parkourlrc/pcb-WantClueTechnologies--BitForge-Nano-ec7b885981/KiCad/BitForgeNano/3d/CUI_DEVICES_PJ-002AH.step

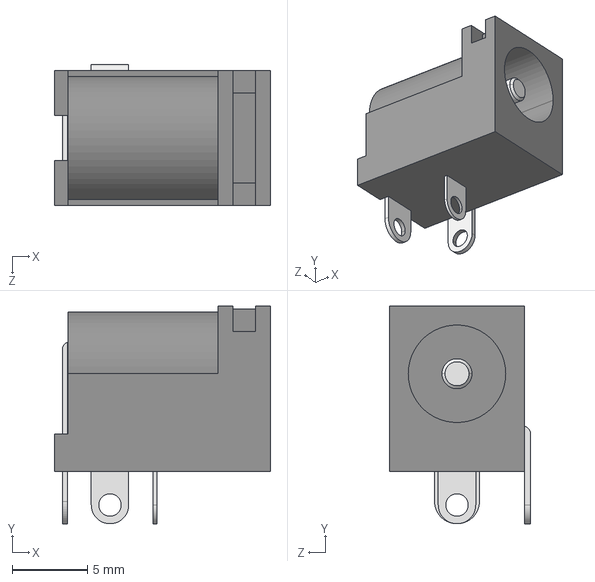
[picture p2: CAD file, 2025-12-21]
KiCad/BitForgeNano/3d/CUI_DEVICES_PJ-002AH.step
14.4 x 14.5 x 9.40 mm
