parkourlrc/pcb-WantClueTechnologies--BitForge-Nano-ec7b885981/KiCad/BitForgeNano/3d/TXB0104RGYR.STEP

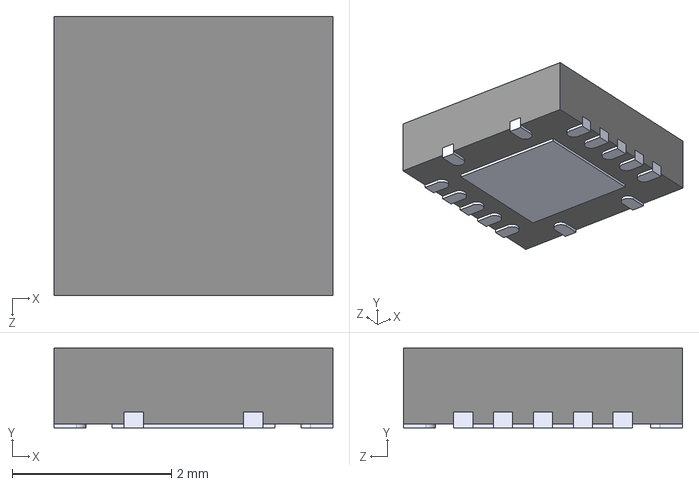
[picture p3: CAD file, 2025-12-21]
KiCad/BitForgeNano/3d/TXB0104RGYR.STEP
3.50 x 1.00 x 3.50 mm
