parkourlrc/pcb-WantClueTechnologies--BitForge-Nano-ec7b885981/KiCad/BitForgeNano/3d/RUM0016A.stp

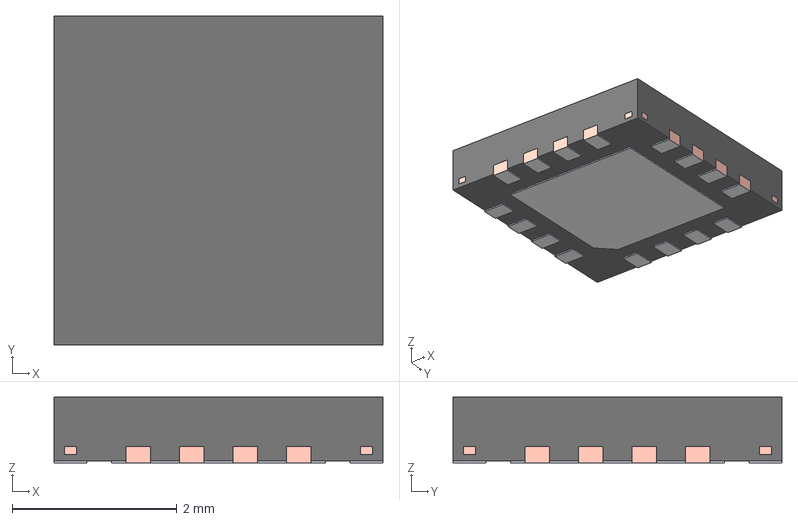
[picture p5: CAD file, 2025-12-21]
KiCad/BitForgeNano/3d/RUM0016A.stp
4.00 x 4.00 x 0.8 mm
FRAME
PIN1_AREA
