parkourlrc/pcb-WantClueTechnologies--BitForge-Nano-ec7b885981/KiCad/BitForgeNano/3d/TPS546D24ARVFR.step

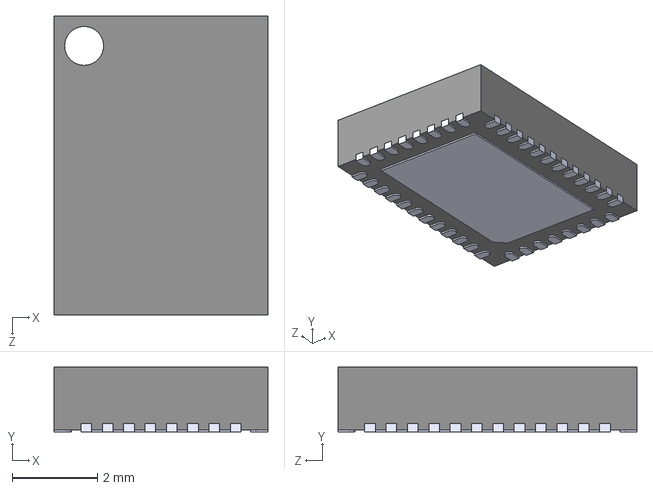
[picture p6: CAD file, 2025-12-21]
KiCad/BitForgeNano/3d/TPS546D24ARVFR.step
5.00 x 1.52 x 7.00 mm
