parkourlrc/pcb-WantClueTechnologies--BitForge-Nano-ec7b885981/KiCad/BitForgeNano/3d/Bitaxe_Heatsink.step

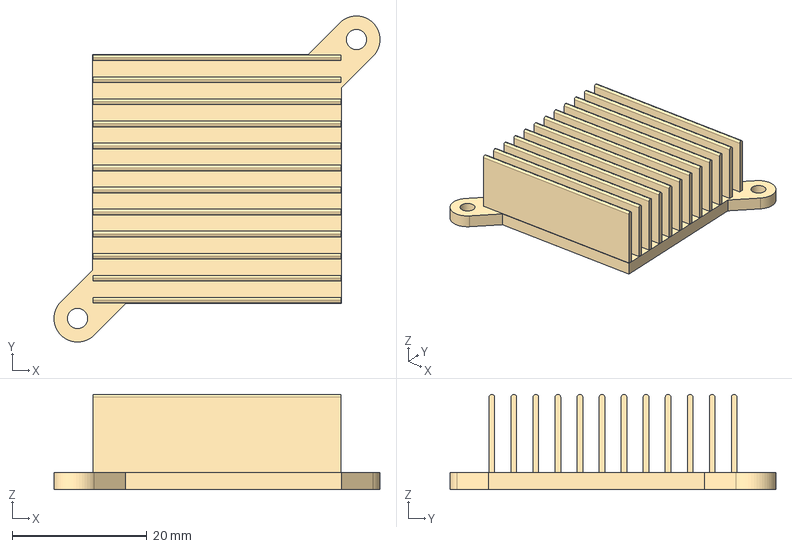
[picture p7: CAD file, 2025-12-21]
KiCad/BitForgeNano/3d/Bitaxe_Heatsink.step
48.4 x 48.4 x 14.1 mm
