parkourlrc/pcb-WantClueTechnologies--BitForge-Nano-ec7b885981/KiCad/BitForgeNano/3d/SMV_z90.stp

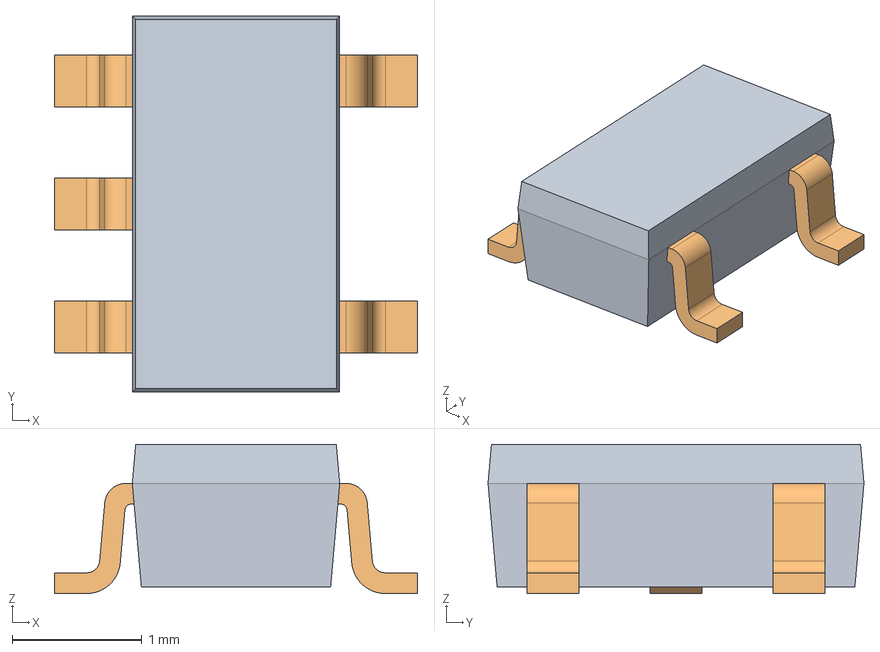
[picture p8: CAD file, 2025-12-21]
KiCad/BitForgeNano/3d/SMV_z90.stp
2.80 x 2.90 x 1.15 mm
