parkourlrc/pcb-WantClueTechnologies--BitForge-Nano-ec7b885981/KiCad/BitForgeNano/3d/oscillator3.2x2.5.step

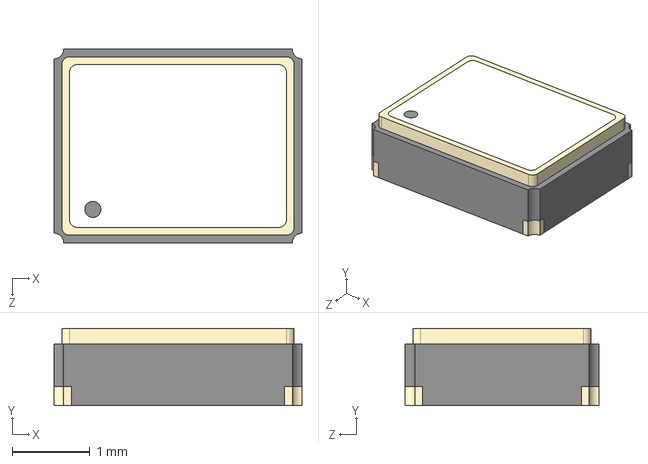
[picture p10: CAD file, 2025-12-21]
KiCad/BitForgeNano/3d/oscillator3.2x2.5.step
3.20 x 1.00 x 2.50 mm
