parkourlrc/pcb-WantClueTechnologies--BitForge-Nano-ec7b885981/KiCad/BitForgeNano/3d/SW_CS1213AGF260_CRS.step

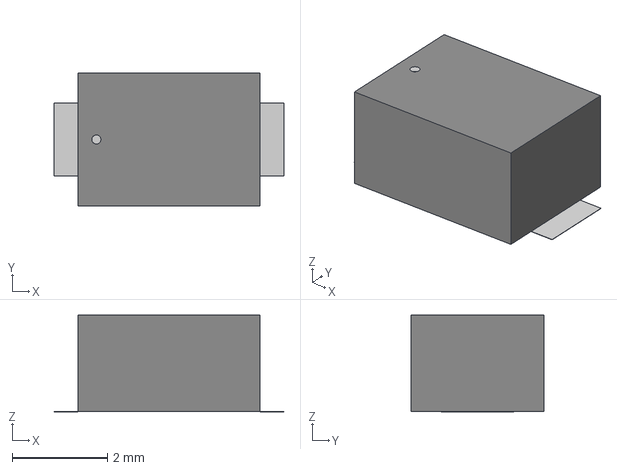
[picture p12: CAD file, 2025-12-21]
KiCad/BitForgeNano/3d/SW_CS1213AGF260_CRS.step
4.83 x 2.79 x 2.04 mm
