parkourlrc/pcb-WantClueTechnologies--BitForge-Nano-ec7b885981/KiCad/BitForgeNano/3d/CUI_DEVICES_PJ-036AH-SMT-TR.step

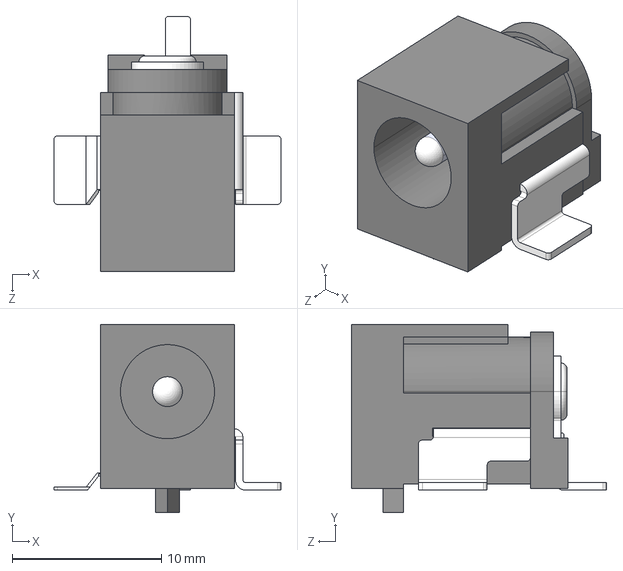
[picture p13: CAD file, 2025-12-21]
KiCad/BitForgeNano/3d/CUI_DEVICES_PJ-036AH-SMT-TR.step
15.2 x 12.6 x 17.1 mm
