parkourlrc/pcb-WantClueTechnologies--BitForge-Nano-ec7b885981/KiCad/BitForgeNano/3d/21-0164B_L622-1_MXM.step

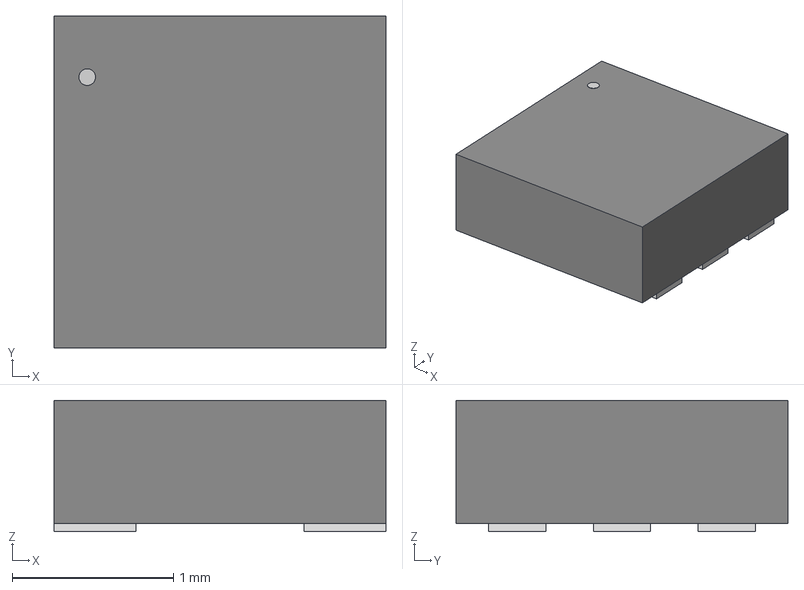
[picture p14: CAD file, 2025-12-21]
KiCad/BitForgeNano/3d/21-0164B_L622-1_MXM.step
2.06 x 2.06 x 0.815 mm
