parkourlrc/pcb-WantClueTechnologies--BitForge-Nano-ec7b885981/KiCad/BitForgeNano/3d/heatsink-13x12x5.step

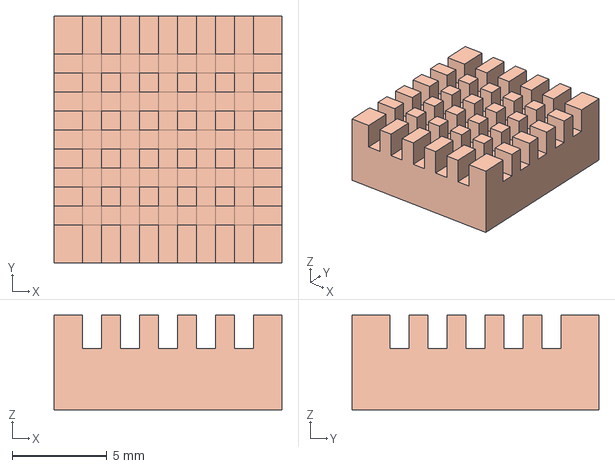
[picture p17: CAD file, 2025-12-21]
KiCad/BitForgeNano/3d/heatsink-13x12x5.step
12.0 x 13.0 x 5.00 mm
