parkourlrc/pcb-WantClueTechnologies--BitForge-Nano-ec7b885981/KiCad/BitForgeNano/3d/TSOT-23-5_RIT.step

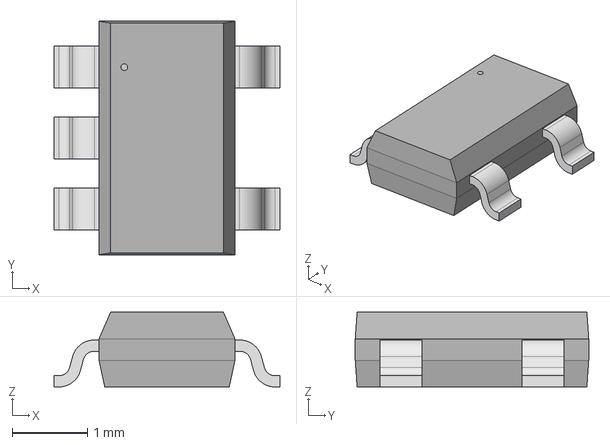
[picture p18: CAD file, 2025-12-21]
KiCad/BitForgeNano/3d/TSOT-23-5_RIT.step
3.00 x 3.10 x 0.993 mm
