parkourlrc/pcb-WantClueTechnologies--BitForge-Nano-ec7b885981/KiCad/BitForgeNano/3d/XRCGB27M120F3M10R0_MUR.step

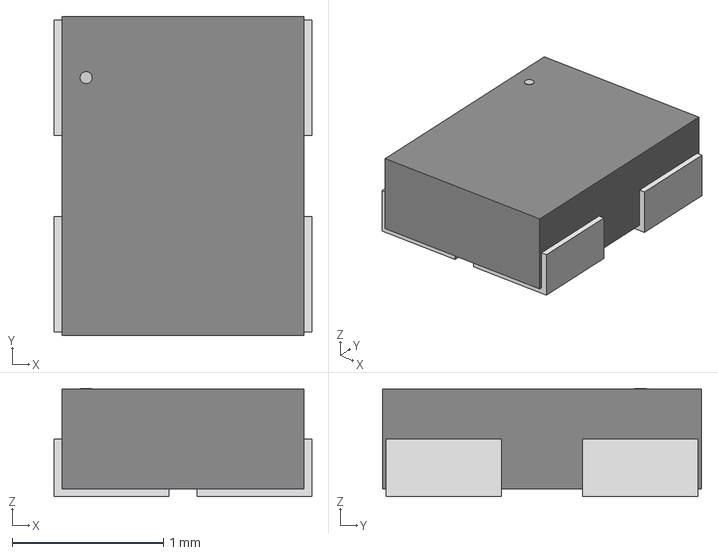
[picture p20: CAD file, 2025-12-21]
KiCad/BitForgeNano/3d/XRCGB27M120F3M10R0_MUR.step
1.70 x 2.11 x 0.714 mm
