parkourlrc/pcb-WantClueTechnologies--BitForge-Nano-ec7b885981/KiCad/BitForgeNano/3d/2R5TPE220MAFB.step

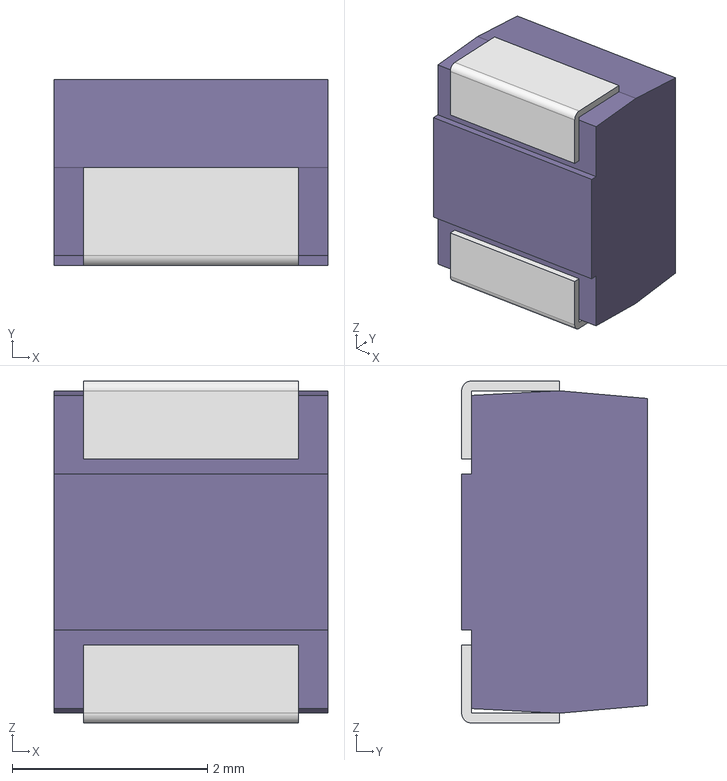
[picture p22: CAD file, 2025-12-21]
KiCad/BitForgeNano/3d/2R5TPE220MAFB.step
2.80 x 1.90 x 3.50 mm
mold-B2
flame-B2 x 2
