parkourlrc/pcb-WantClueTechnologies--BitForge-Nano-ec7b885981/KiCad/BitForgeNano/3d/Coilcraft-SLC1175.STEP

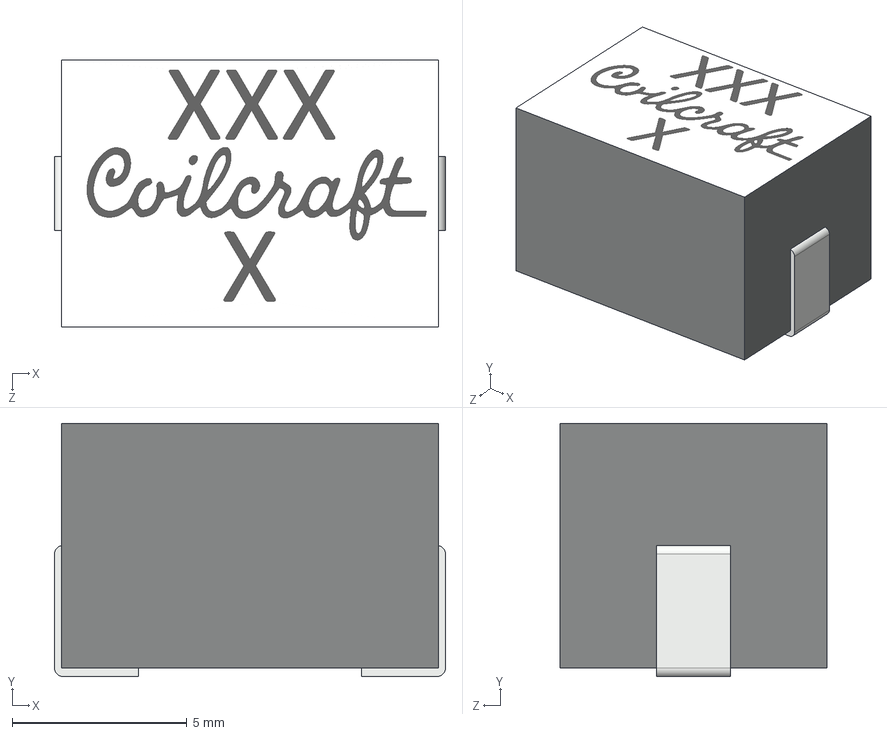
[picture p23: CAD file, 2025-12-21]
KiCad/BitForgeNano/3d/Coilcraft-SLC1175.STEP
11.2 x 7.25 x 7.65 mm
