parkourlrc/pcb-WantClueTechnologies--BitForge-Nano-ec7b885981/KiCad/BitForgeNano/3d/DISST7789-176x320.STEP

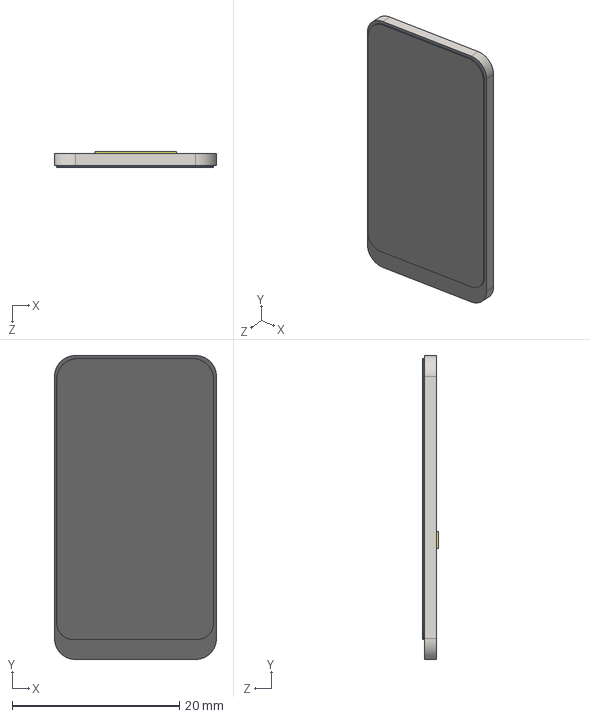
[picture p25: CAD file, 2025-12-21]
KiCad/BitForgeNano/3d/DISST7789-176x320.STEP
19.4 x 36.4 x 1.86 mm
