parkourlrc/pcb-WantClueTechnologies--BitForge-Nano-ec7b885981/KiCad/BitForgeNano/3d/SLC1175-271MEC_COC.step

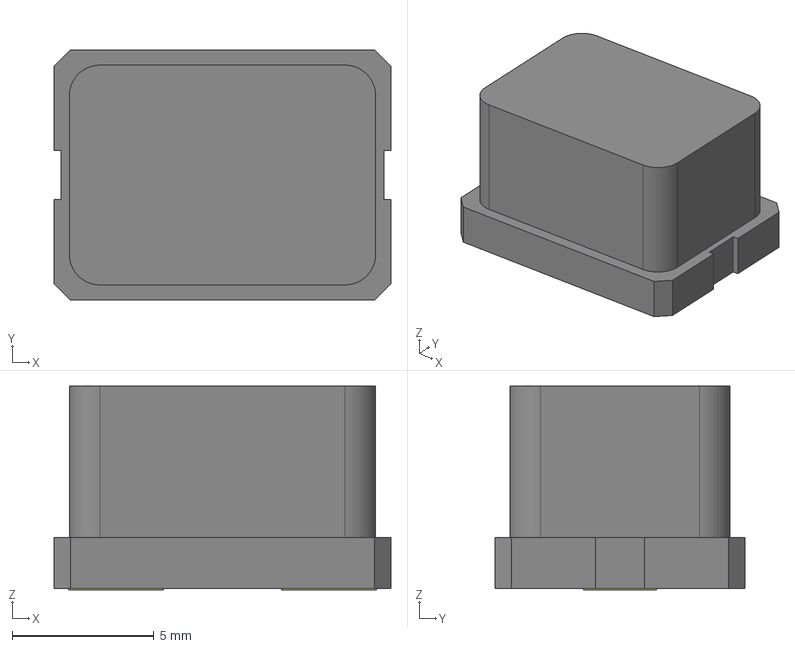
[picture p27: CAD file, 2025-12-21]
KiCad/BitForgeNano/3d/SLC1175-271MEC_COC.step
11.9 x 8.83 x 7.19 mm
