parkourlrc/pcb-WantClueTechnologies--BitForge-Nano-ec7b885981/KiCad/BitForgeNano/3d/BM1368xx.stp

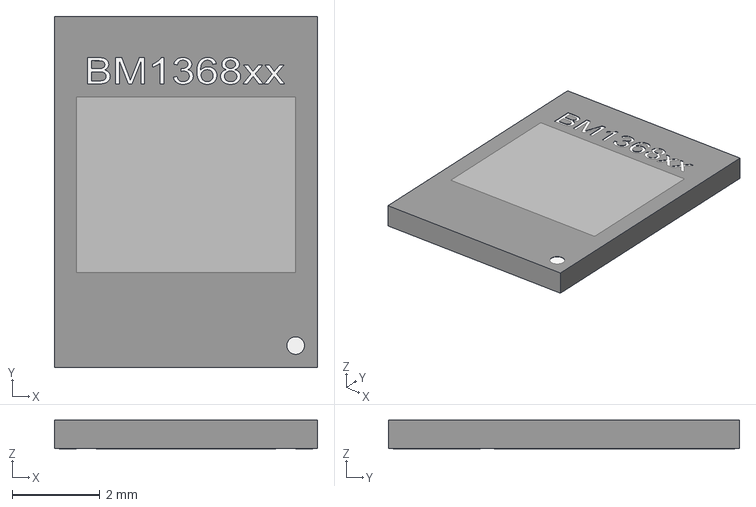
[picture p28: CAD file, 2025-12-21]
KiCad/BitForgeNano/3d/BM1368xx.stp
6.00 x 8.00 x 0.65 mm
