parkourlrc/pcb-WantClueTechnologies--BitForge-Nano-ec7b885981/KiCad/BitForgeNano/3d/SOT-23-5_M5_MCH.step

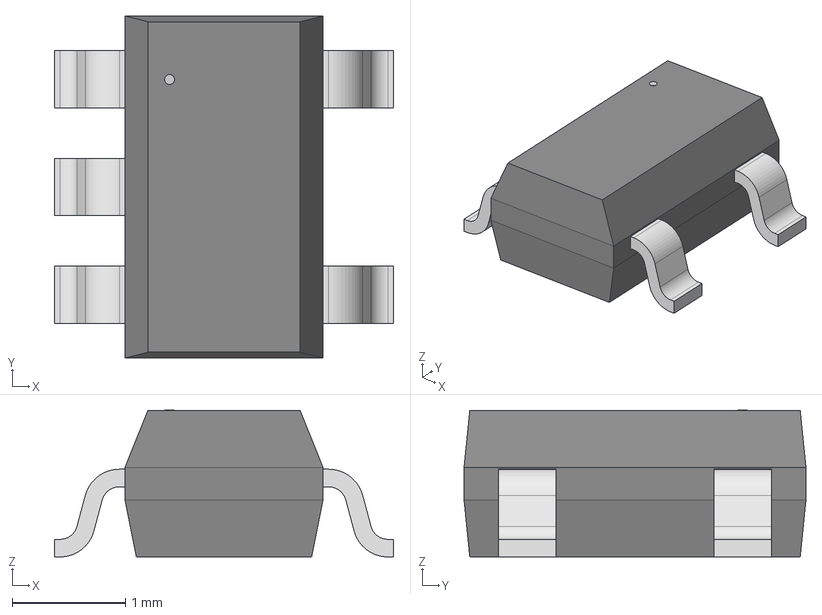
[picture p29: CAD file, 2025-12-21]
KiCad/BitForgeNano/3d/SOT-23-5_M5_MCH.step
3.00 x 3.02 x 1.30 mm
