parkourlrc/pcb-WantClueTechnologies--BitForge-Nano-ec7b885981/KiCad/BitForgeNano/3d/CUI_DEVICES_PJ-037AH.step

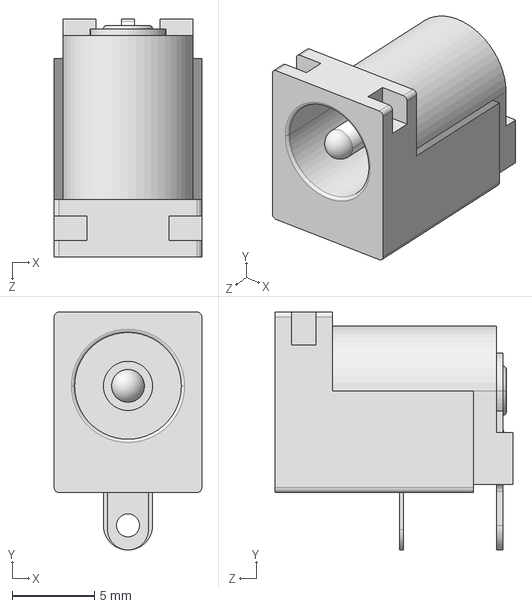
[picture p33: CAD file, 2025-12-21]
KiCad/BitForgeNano/3d/CUI_DEVICES_PJ-037AH.step
9.00 x 14.5 x 14.5 mm
