parkourlrc/pcb-WantClueTechnologies--BitForge-Nano-ec7b885981/KiCad/BitForgeNano/3d/c-63862-1-r-3d.stp

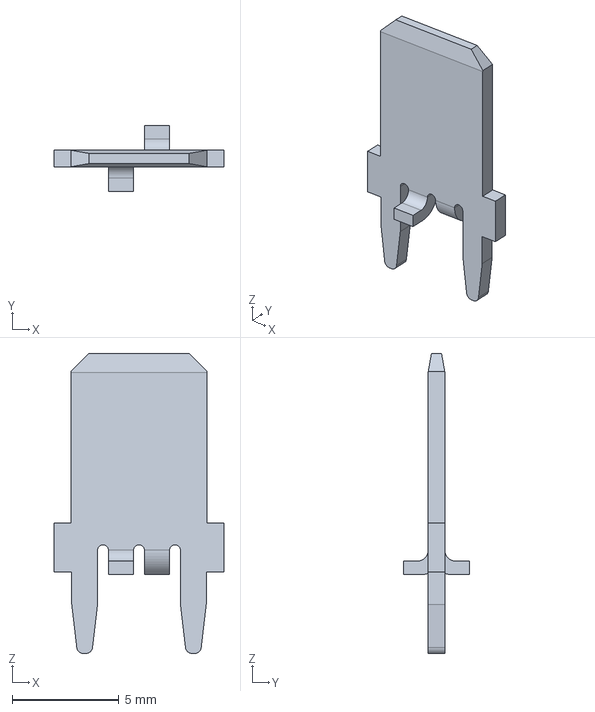
[picture p34: CAD file, 2025-12-21]
KiCad/BitForgeNano/3d/c-63862-1-r-3d.stp
7.92 x 3.07 x 14.0 mm
