parkourlrc/pcb-WantClueTechnologies--BitForge-Nano-ec7b885981/KiCad/BitForgeNano/3d/CS1213AG-tr.stp

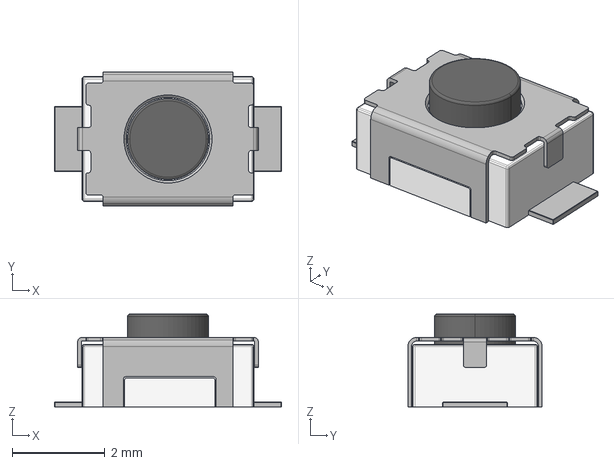
[picture p35: CAD file, 2025-12-21]
KiCad/BitForgeNano/3d/CS1213AG-tr.stp
4.90 x 2.90 x 2.00 mm
