parkourlrc/pcb-WantClueTechnologies--BitForge-Nano-ec7b885981/KiCad/BitForgeNano/3d/SN74AXC1T45DBVR.STEP

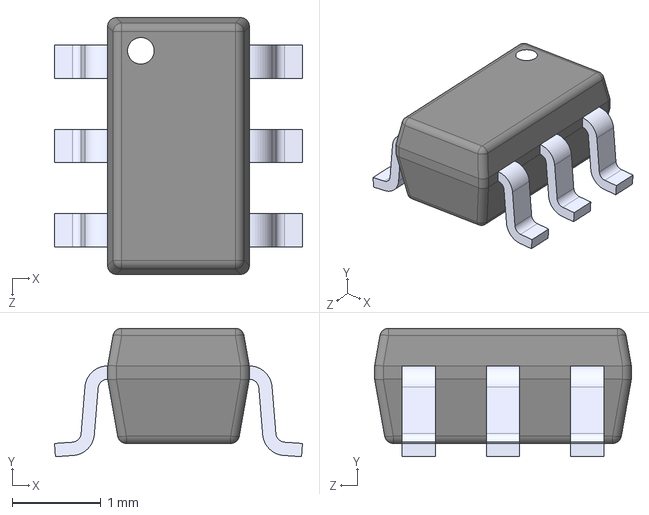
[picture p36: CAD file, 2025-12-21]
KiCad/BitForgeNano/3d/SN74AXC1T45DBVR.STEP
2.80 x 1.45 x 2.90 mm
