parkourlrc/pcb-WantClueTechnologies--BitForge-Nano-ec7b885981/KiCad/BitForgeNano/3d/SX3M25.000E20F30THN.step

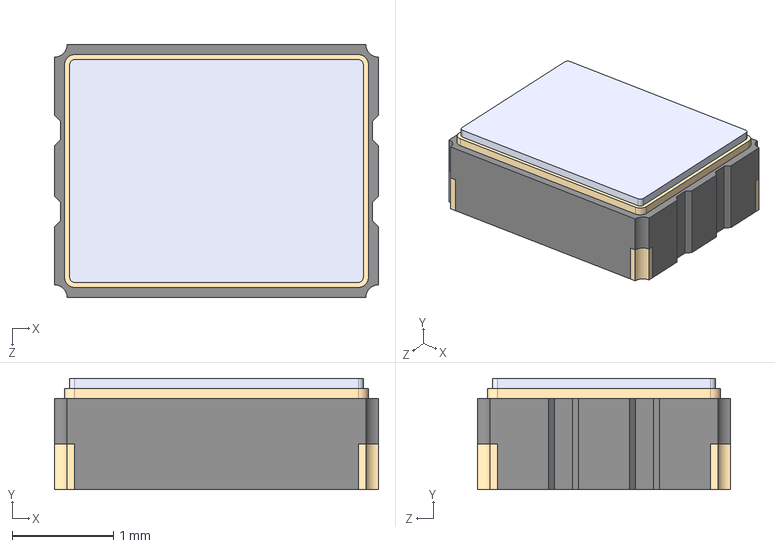
[picture p37: CAD file, 2025-12-21]
KiCad/BitForgeNano/3d/SX3M25.000E20F30THN.step
3.20 x 1.10 x 2.50 mm
