parkourlrc/pcb-WantClueTechnologies--BitForge-Nano-ec7b885981/KiCad/BitForgeNano/3d/FP1007R3-R15-R.stp

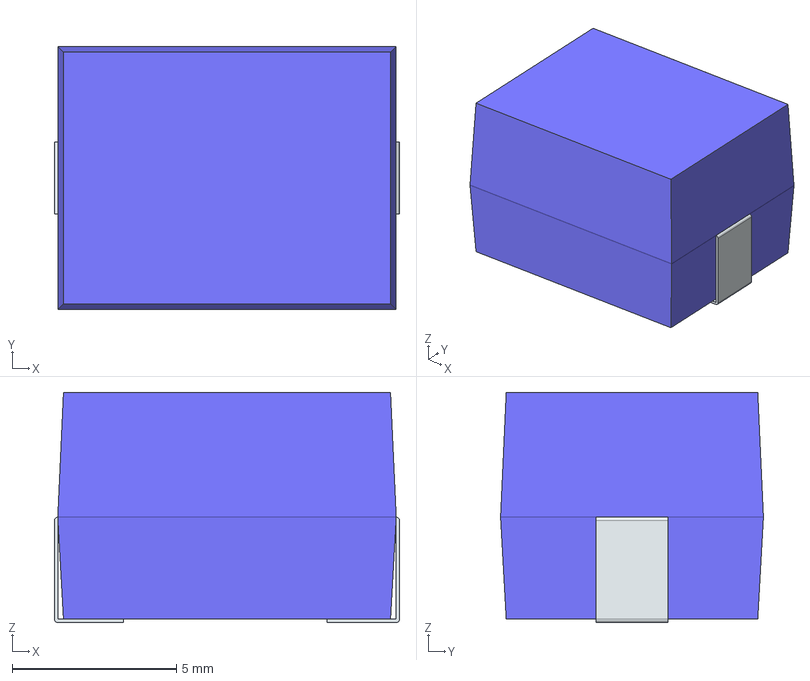
[picture p38: CAD file, 2025-12-21]
KiCad/BitForgeNano/3d/FP1007R3-R15-R.stp
10.5 x 8.00 x 7.00 mm
FilletPin1
FilletPin2
