parkourlrc/pcb-WantClueTechnologies--BitForge-Nano-ec7b885981/KiCad/BitForgeNano/3d/USB_10118193-0001LF.STEP

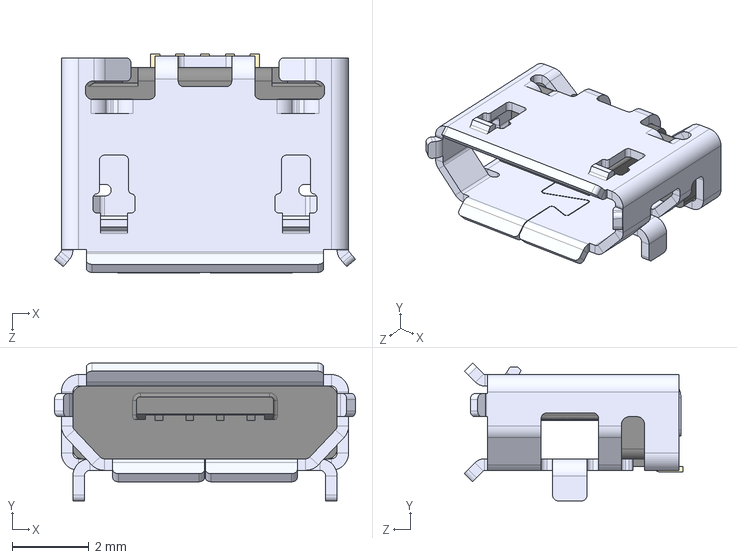
[picture p40: CAD file, 2025-12-21]
KiCad/BitForgeNano/3d/USB_10118193-0001LF.STEP
7.86 x 3.60 x 5.71 mm
