parkourlrc/pcb-WantClueTechnologies--BitForge-Nano-ec7b885981/KiCad/BitForgeNano/3d/SUNON Fan 60x60x15 mm.STEP

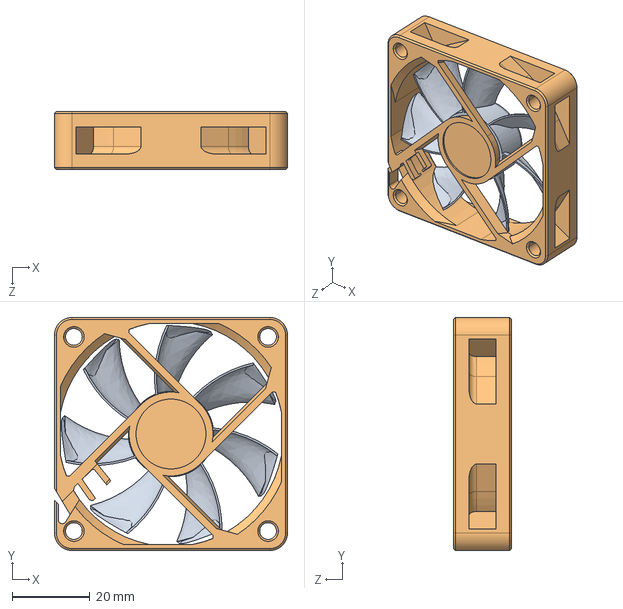
[picture p43: CAD file, 2025-12-21]
KiCad/BitForgeNano/3d/SUNON Fan 60x60x15 mm.STEP
60.0 x 60.0 x 15.0 mm
Fan Wheel
Fan-Sunont_60x60x15mm
