parkourlrc/pcb-WantClueTechnologies--BitForge-Nano-ec7b885981/KiCad/BitForgeNano/3d/IHLP2020CZ.step

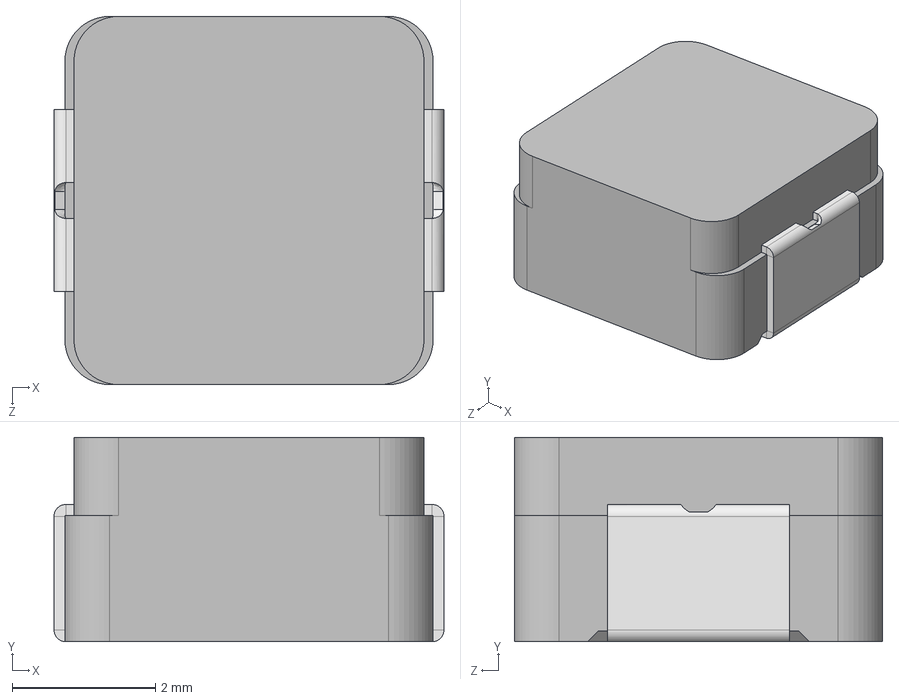
[picture p44: CAD file, 2025-12-21]
KiCad/BitForgeNano/3d/IHLP2020CZ.step
5.45 x 2.86 x 5.15 mm
