parkourlrc/pcb-WantClueTechnologies--BitForge-Nano-ec7b885981/(list of files, cad)

Other CAD files:
KiCad/BitForgeNano/BitForgeNano_Medium.step
KiCad/BitForgeNano/3d/470531000.stp
KiCad/BitForgeNano/3d/78438357082.stp
KiCad/BitForgeNano/3d/CSD16340Q3.step
KiCad/BitForgeNano/3d/LM27402SQ_NOPB.step
KiCad/BitForgeNano/BitForgeNano_Case v14.f3d
