parkourlrc/pcb-WantClueTechnologies--BitForge-Nano-ec7b885981/KiCad/BitForgeNano/BitForgeNano.kicad_pcb

## KiCad design KiCad/BitForgeNano/BitForgeNano.kicad_pcb (2025-12-21)

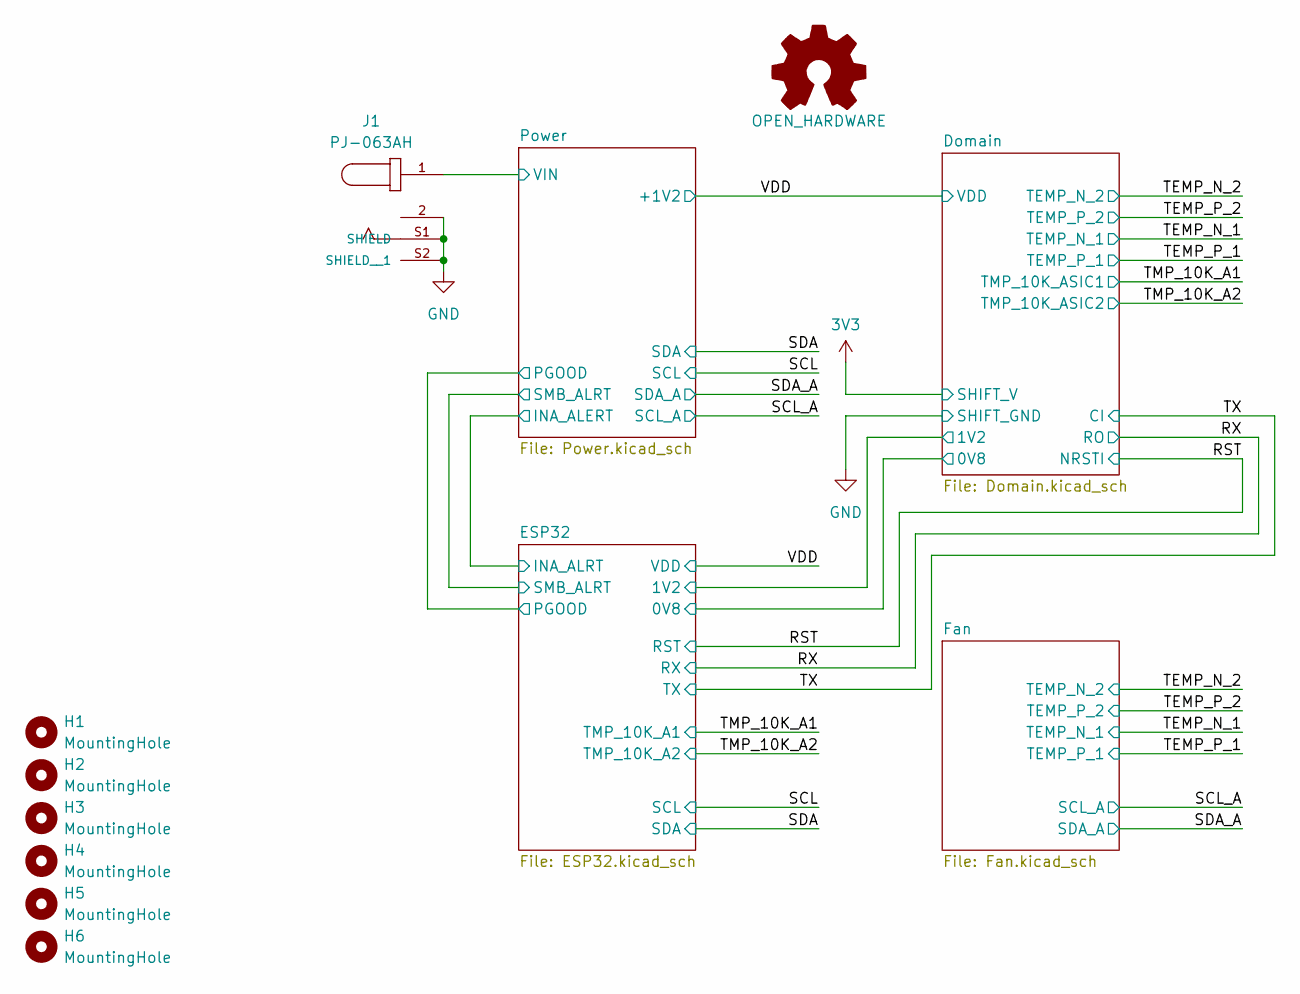
[picture p45: schematic BitForgeNano.kicad_sch]

Parts:
H1, H2, H3, H4, H5, H6: MountingHole; MountingHole_3.2mm_M3_ISO14580
J1: PJ-063AH; BarrelJack_CUI_PJ-063AH_Horizontal; PARTREV 1.02
LOGO1: OPEN_HARDWARE; OSHW-Logo_5.7x6mm_SilkScreen

Connections:
/Power/VIN: J1.1; also elsewhere on the board
GND: J1.2, J1.S1 (SHIELD), J1.S2 (SHIELD__1); also elsewhere on the board

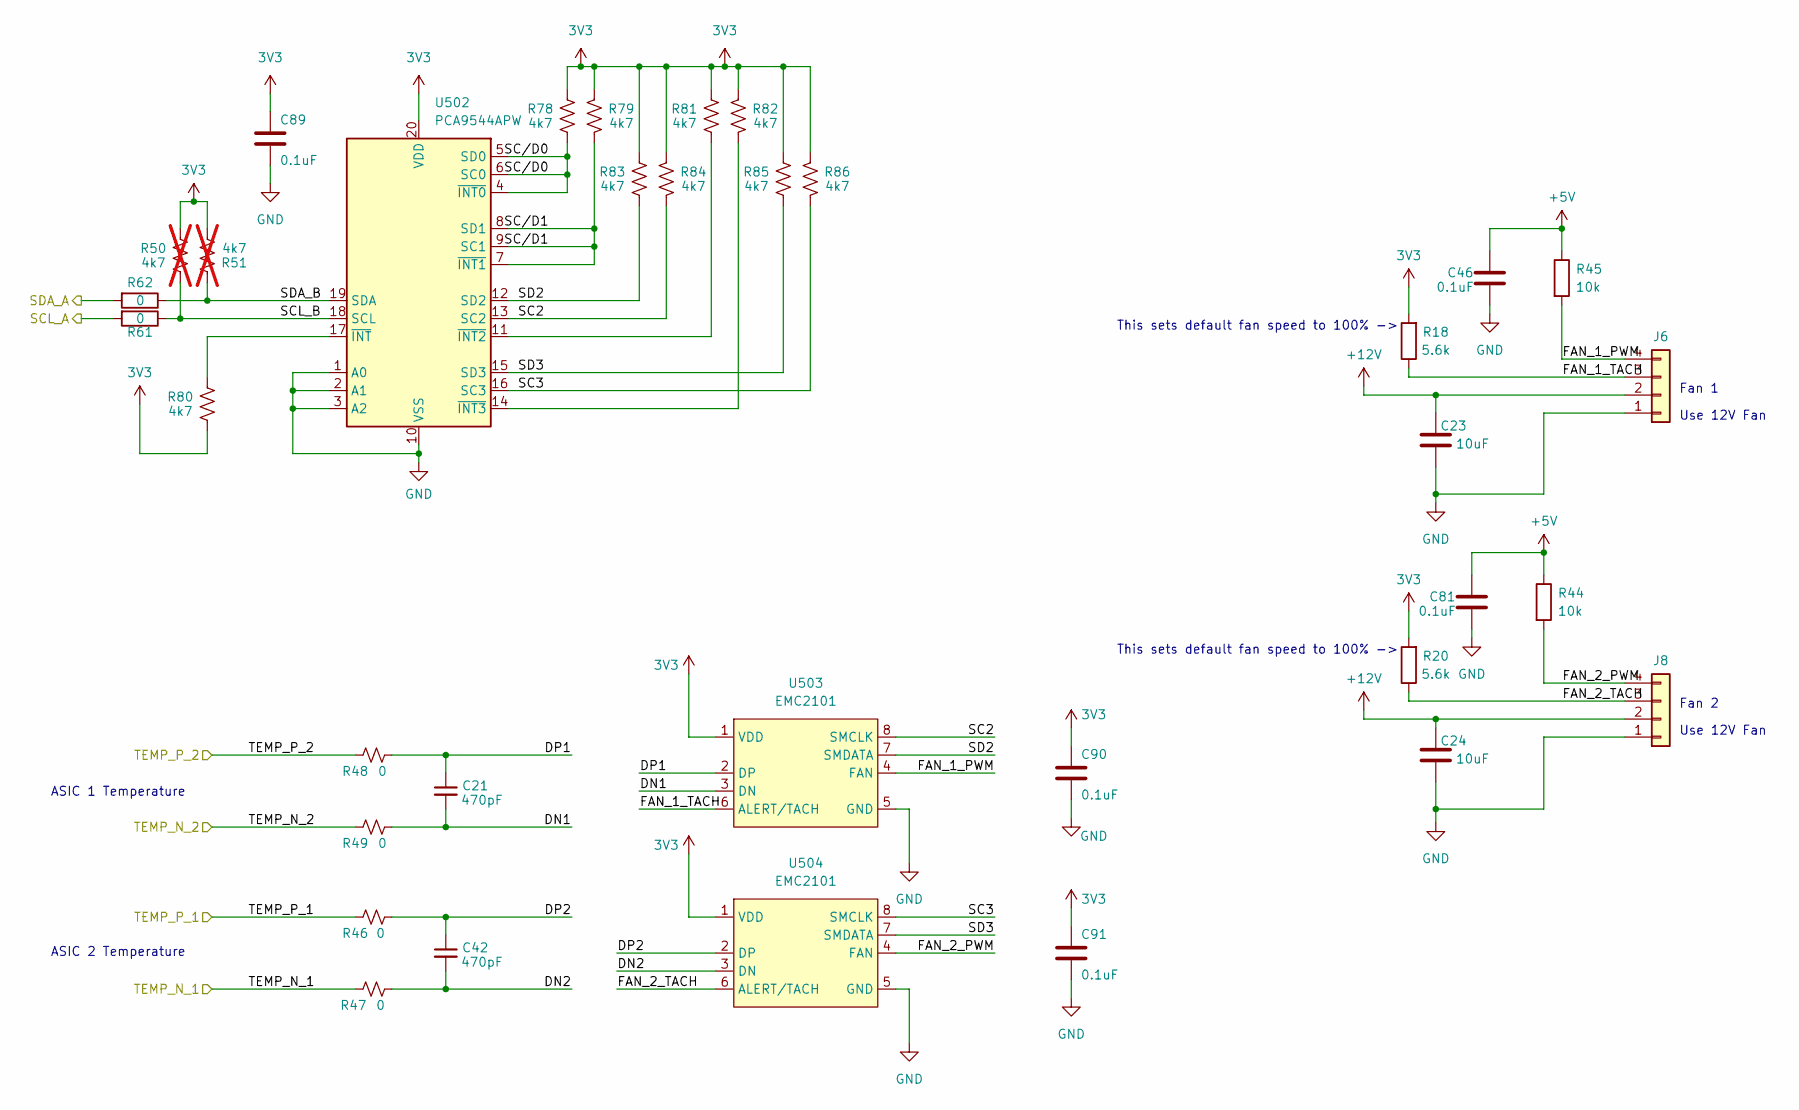
[picture p46: schematic Fan.kicad_sch, BitForgeNano]

Parts:
C21, C42: 470pF; C_0402_1005Metric; PARTNO GRM1555C1H471JA01D
C23, C24: 10uF; C_0603_1608Metric
C46, C81: 0.1uF; C_0402_1005Metric; PARTNO KGM05AR71C104KH
C89, C90, C91: 0.1uF; C_0402_1005Metric
J6, J8: Conn_01x04; 470531000; PARTNO 0470531000
R18, R20: 5.6k; R_0402_1005Metric
R44, R45: 10k; R_0402_1005Metric
R46, R47, R48, R49, R61, R62: 0; R_0402_1005Metric; PARTNO RC0402JR-070RL
R50, R51: 4k7; R_0805_2012Metric; not fitted
R78, R79, R80, R81, R82, R83, R84, R85, R86: 4k7; R_0402_1005Metric
U502: PCA9544APW; TSSOP-20_4.4x6.5mm_P0.65mm
U503, U504: EMC2101; TSSOP-8_3x3mm_P0.65mm; PARTNO EMC2101-R-ACZL-TR

Connections:
3V3: C89.1, C90.1, C91.1, R18.2, R20.2, R50.2, R51.1, R78.2, R79.2, R80.1, R81.2, R82.2, R83.2, R84.2, R85.2, R86.2, U502.20 (VDD), U503.1 (VDD), U504.1 (VDD); also elsewhere on the board
+5V: C46.1, C81.1, R44.1, R45.1; also elsewhere on the board
+12V: C23.1, C24.1, J6.2, J8.2; also elsewhere on the board
/Fan/DN1: C21.2, R49.1, U503.3 (DN)
/Fan/DN2: C42.2, R47.1, U504.3 (DN)
/Fan/DP1: C21.1, R48.1, U503.2 (DP)
/Fan/DP2: C42.1, R46.1, U504.2 (DP)
/Fan/FAN_1_PWM: J6.4, R45.2, U503.4 (FAN)
/Fan/FAN_1_TACH: J6.3, R18.1, U503.6 (ALERT/TACH)
/Fan/FAN_2_PWM: J8.4, R44.2, U504.4 (FAN)
/Fan/FAN_2_TACH: J8.3, R20.1, U504.6 (ALERT/TACH)
/Fan/SC2: R84.1, U502.13 (SC2), U503.8 (SMCLK)
/Fan/SC3: R86.1, U502.16 (SC3), U504.8 (SMCLK)
/Fan/SCL_B: R50.1, R61.1, U502.18 (SCL)
/Fan/SC/D0: R78.1, U502.4 (~INT0), U502.5 (SD0), U502.6 (SC0)
/Fan/SC/D1: R79.1, U502.7 (~INT1), U502.8 (SD1), U502.9 (SC1)
/Fan/SD2: R83.1, U502.12 (SD2), U503.7 (SMDATA)
/Fan/SD3: R85.1, U502.15 (SD3), U504.7 (SMDATA)
/Fan/SDA_B: R51.2, R62.1, U502.19 (SDA)
/SCL_A: R61.2; also elsewhere on the board
/SDA_A: R62.2; also elsewhere on the board
/TEMP_N_1: R47.2; also elsewhere on the board
/TEMP_N_2: R49.2; also elsewhere on the board
/TEMP_P_1: R46.2; also elsewhere on the board
/TEMP_P_2: R48.2; also elsewhere on the board
GND: C23.2, C24.2, C46.2, C81.2, C89.2, C90.2, C91.2, J6.1, J8.1, U502.1 (A0), U502.2 (A1), U502.3 (A2), U502.10 (VSS), U503.5 (GND), U504.5 (GND); also elsewhere on the board
unnamed: R81.1, U502.11 (~INT2)
unnamed: R82.1, U502.14 (~INT3)
unnamed: R80.2, U502.17 (~INT)

Notes on the sheet:
Fan 1
This sets default fan speed to 100% ->
ASIC 2 Temperature
Use 12V Fan
Fan 2
ASIC 1 Temperature

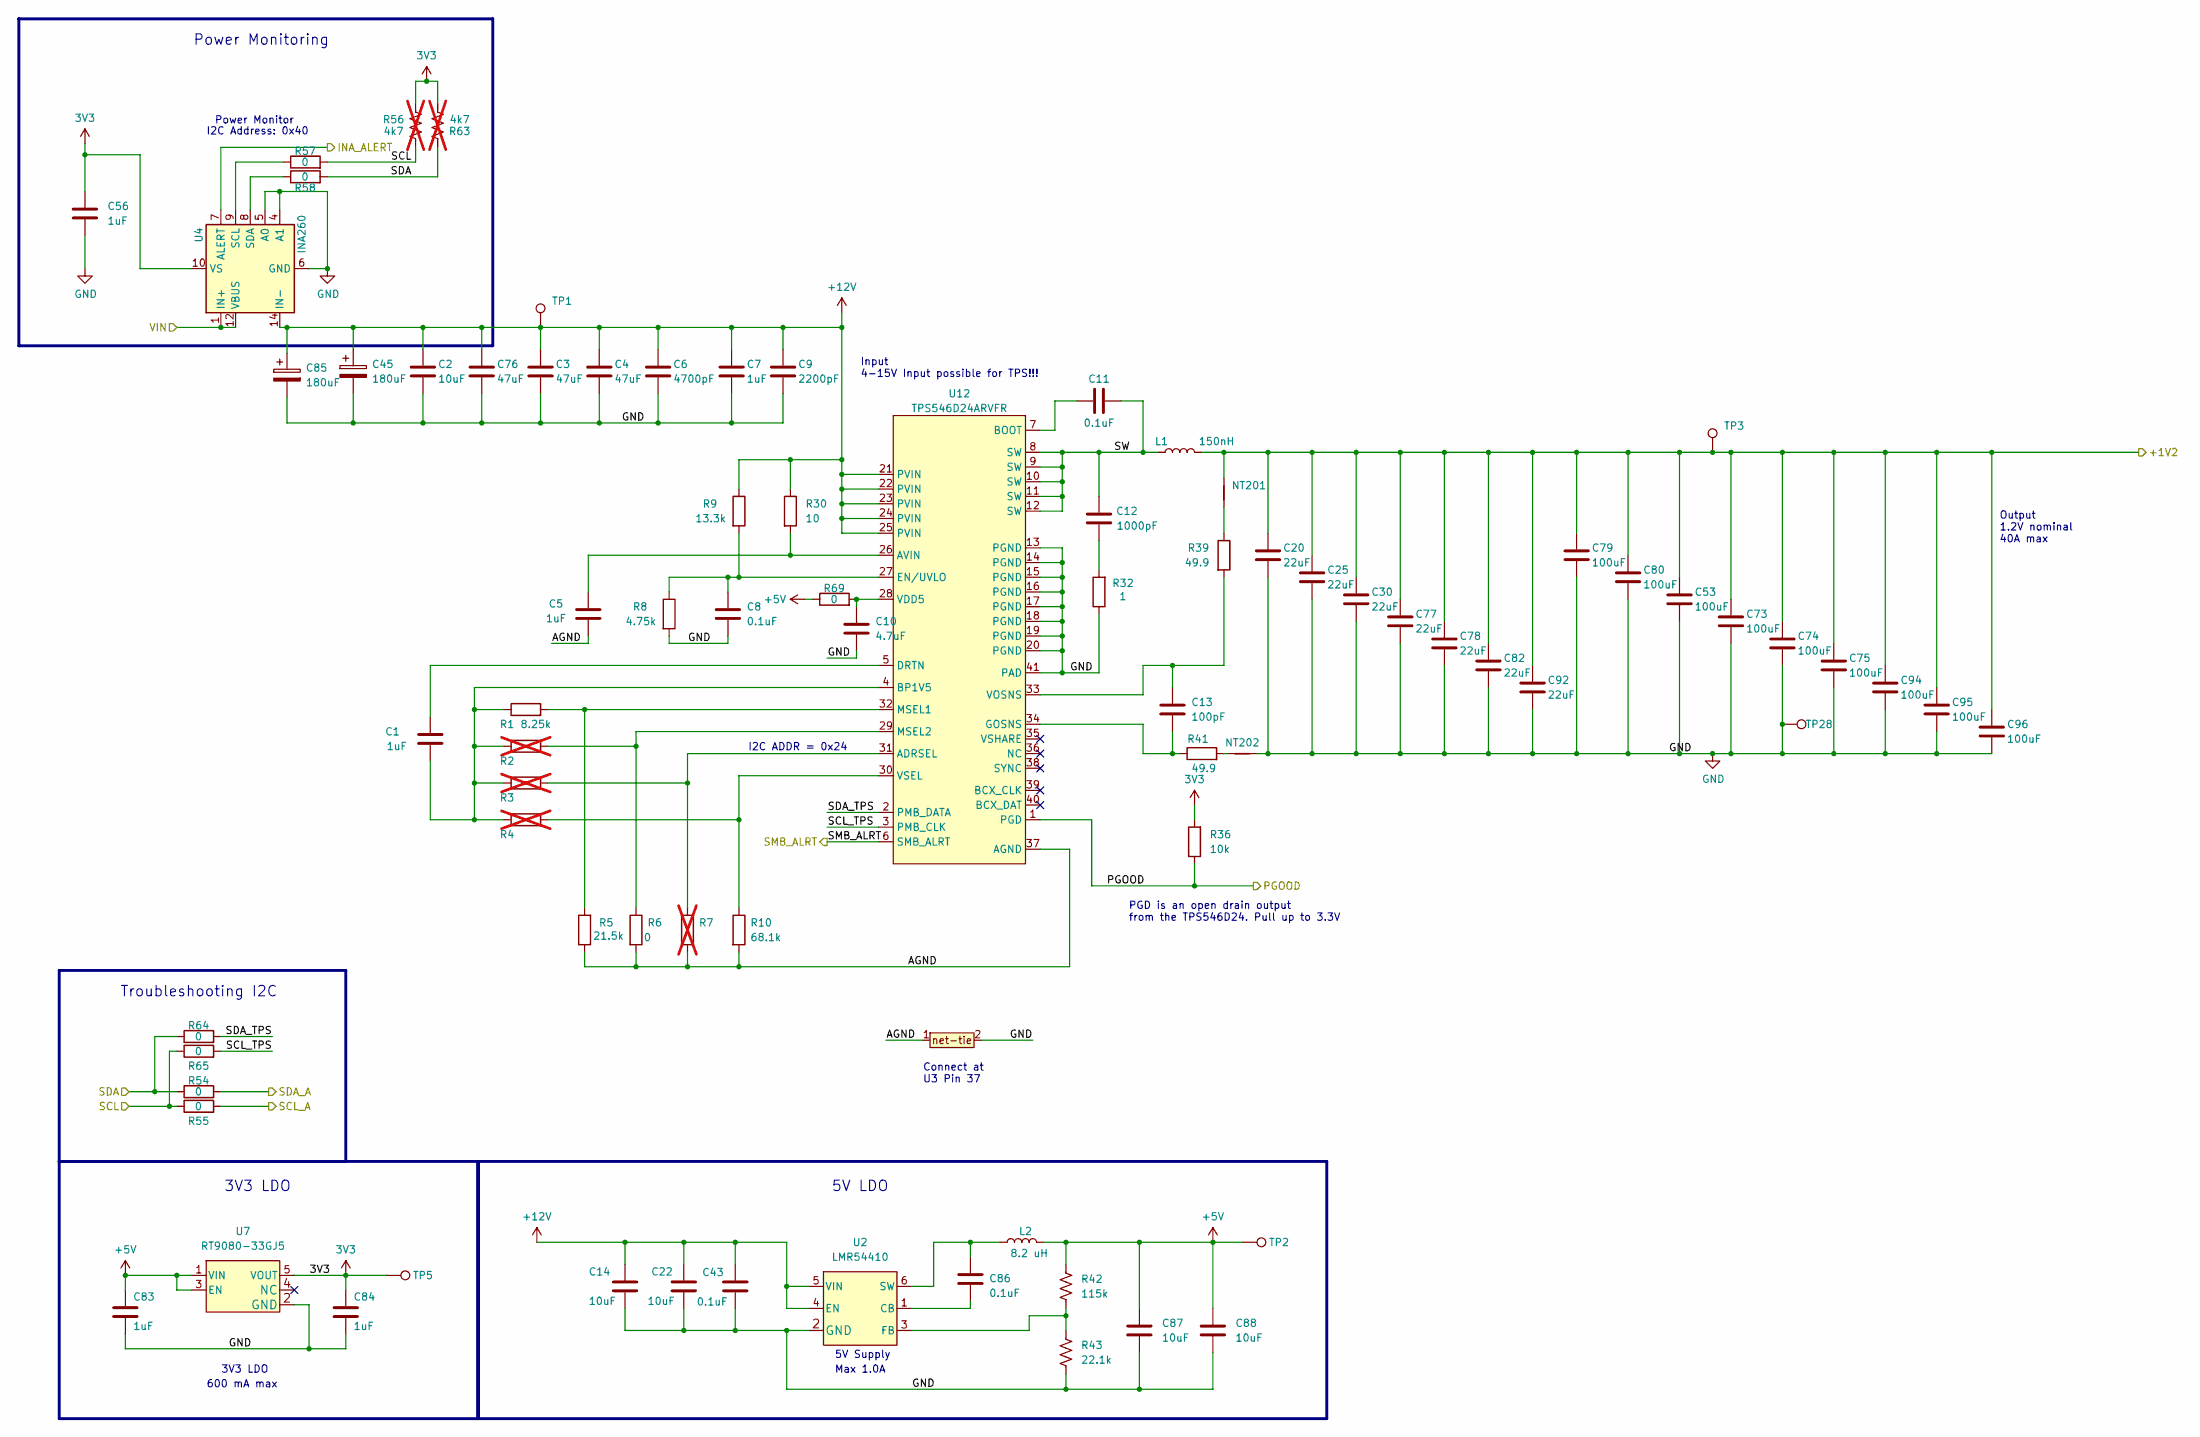
[picture p47: schematic Power.kicad_sch, BitForgeNano]

Parts:
C1, C5, C7, C56, C83, C84: 1uF; C_0402_1005Metric; PARTNO EMK105BJ105MV-F
C2: 10uF; C_0805_2012Metric; PARTNO CL21A106KOQNNNE
C3, C4, C76: 47uF; C_1210_3225Metric; PARTNO CL32A476KOJNNNE
C6: 4700pF; C_0402_1005Metric; PARTNO GRM155R71E472KA01D
C8, C11: 0.1uF; C_0402_1005Metric; PARTNO CL05A104KO5NNNC
C9: 2200pF; C_0402_1005Metric; PARTNO GRM155R61H222KA01D
C10: 4.7uF; C_0402_1005Metric; PARTNO GRM155R61A475MEAAD
C12: 1000pF; C_0805_2012Metric; PARTNO CC0805KRX7R9BB102
C13: 100pF; C_0402_1005Metric; PARTNO 885012005013
C14, C22, C87, C88: 10uF; C_0805_2012Metric; PARTNO GRM21BR61H106ME43L
C20, C25, C30, C77, C78, C82, C92: 22uF; C_0805_2012Metric; PARTNO GRM21BR61A226ME44L
C43: 0.1uF; C_0603_1608Metric; PARTNO KGM15BR71H104KT
C45, C85: 180uF; CP_Elec_6.3x5.9; PARTNO 16SVPF180M
C53, C73, C74, C75, C79, C80, C94, C95, C96: 100uF; C_1206_3216Metric; PARTNO CL31A107MQHNNNE
C86: 0.1uF; C_0402_1005Metric; PARTNO KGM05AR71C104KH
L1: 150nH; FP1007R3-R15-R; PARTNO FP1007R3-R15-R
L2: 8.2 uH; Inductor-74438357082; PARTNO 78438357082
NT201, NT202: NetTie_2; NetTie-2_SMD_Pad0.5mm
R1: 8.25k; R_0402_1005Metric; PARTNO CRCW040214K7FKED
R2, R3, R4, R7: R_0402_1005Metric; not fitted
R5: 21.5k; R_0402_1005Metric; PARTNO CRCW040221K5FKED
R6, R54, R55, R57, R58, R64, R65, R69: 0; R_0402_1005Metric; PARTNO RC0402JR-070RL
R8: 4.75k; R_0402_1005Metric; PARTNO CRCW04024K75FKED
R9: 13.3k; R_0402_1005Metric; PARTNO CRCW040213K3FKED
R10: 68.1k; R_0402_1005Metric; PARTNO RC0402FR-0768K1L
R30: 10; R_0402_1005Metric; PARTNO RC0402FR-0710RL
R32: 1; R_1206_3216Metric; PARTNO CSR1206FT1R00
R36: 10k; R_0402_1005Metric; PARTNO RC0402JR-0710KL
R39, R41: 49.9; R_0402_1005Metric; PARTNO RC0402FR-0749R9L
R42: 115k; R_0402_1005Metric; PARTNO RC0402FR-07115KL
R43: 22.1k; R_0402_1005Metric; PARTNO RC0402FR-0722K1L
R56, R63: 4k7; R_0402_1005Metric; not fitted
T1: net-tie; NetTie-2_SMD_Pad0.5mm
TP1, TP2, TP3, TP5: TestPoint; TestPoint_Pad_D1.0mm
TP28: TestPoint; TestPoint_Pad_D1.5mm
U2: LMR54410; SOT-23-6; PARTNO LMR54410FDBVR
U4: INA260; TSSOP-16_4.4x5mm_P0.65mm; PARTNO INA260AIPWR
U7: RT9080-33GJ5; PARTNO RT9080-33GJ5
U12: TPS546D24ARVFR; LQFN40-CLIP; PARTNO TPS546D24ARVFR

Connections:
3V3: C56.1, C84.1, R36.2, R56.2, R63.1, TP5.1, U4.10 (VS), U7.5 (VOUT); also elsewhere on the board
+5V: C83.1, C87.1, C88.1, L2.2, R42.1, R69.1, TP2.1, U7.1 (VIN), U7.3 (EN); also elsewhere on the board
+12V: C2.1, C3.1, C4.1, C6.1, C7.1, C9.1, C14.1, C22.1, C43.2, C45.1, C76.1, C85.1, R9.1, R30.1, TP1.1, U2.4 (EN), U2.5 (VIN), U4.14 (IN-), U4.15 (IN-), U4.16 (IN-), U12.21 (PVIN), U12.22 (PVIN), U12.23 (PVIN), U12.24 (PVIN), U12.25 (PVIN); also elsewhere on the board
/ESP32/INA_ALRT: U4.7 (ALERT); also elsewhere on the board
/Power/AGND: C5.1, R5.1, R6.2, R7.2, R10.2, T1.1, U12.37 (AGND)
/Power/PGOOD: R36.1, U12.1 (PGD); also elsewhere on the board
/Power/SCL_TPS: R65.2, U12.3 (PMB_CLK)
/Power/SDA_TPS: R64.2, U12.2 (PMB_DATA)
/Power/SMB_ALRT: U12.6 (SMB_ALRT); also elsewhere on the board
/Power/SW: C11.2, C12.2, L1.1, U12.8 (SW), U12.9 (SW), U12.10 (SW), U12.11 (SW), U12.12 (SW)
/Power/VIN: U4.1 (IN+), U4.2 (IN+), U4.3 (IN+), U4.12 (VBUS); also elsewhere on the board
/SCL: R55.1, R56.1, R57.2, R65.1; also elsewhere on the board
/SCL_A: R55.2; also elsewhere on the board
/SDA: R54.1, R58.2, R63.2, R64.1; also elsewhere on the board
/SDA_A: R54.2; also elsewhere on the board
/VDD: C20.1, C25.1, C30.1, C53.1, C73.1, C74.1, C75.1, C77.1, C78.1, C79.1, C80.1, C82.1, C92.1, C94.1, C95.1, C96.1, L1.2, NT201.2, TP3.1; also elsewhere on the board
GND: C2.2, C3.2, C4.2, C6.2, C7.2, C8.2, C9.2, C10.2, C14.2, C20.2, C22.2, C25.2, C30.2, C43.1, C45.2, C53.2, C56.2, C73.2, C74.2, C75.2, C76.2, C77.2, C78.2, C79.2, C80.2, C82.2, C83.2, C84.2, C85.2, C87.2, C88.2, C92.2, C94.2, C95.2, C96.2, NT202.2, R8.2, R32.1, R43.2, T1.2, TP28.1, U2.2 (GND), U4.4 (A1), U4.5 (A0), U4.6 (GND), U4.11 (GND), U7.2 (GND), U12.13 (PGND), U12.14 (PGND), U12.15 (PGND), U12.16 (PGND), U12.17 (PGND), U12.18 (PGND), U12.19 (PGND), U12.20 (PGND), U12.41 (PAD); also elsewhere on the board
unnamed: C12.1, R32.2
unnamed: NT201.1, R39.1
unnamed: NT202.1, R41.2
unnamed: C86.2, U2.1 (CB)
unnamed: R42.2, R43.1, U2.3 (FB)
unnamed: C86.1, L2.1, U2.6 (SW)
unnamed: R57.1, U4.9 (SCL)
unnamed: R58.1, U4.8 (SDA)
unnamed: R3.2, R7.1, U12.31 (ADRSEL)
unnamed: C5.2, R30.2, U12.26 (AVIN)
unnamed: C11.1, U12.7 (BOOT)
unnamed: C1.2, R1.1, R2.1, R3.1, R4.1, U12.4 (BP1V5)
unnamed: C1.1, U12.5 (DRTN)
unnamed: C8.1, R8.1, R9.2, U12.27 (EN/UVLO)
unnamed: C13.2, R41.1, U12.34 (GOSNS)
unnamed: R1.2, R5.2, U12.32 (MSEL1)
unnamed: R2.2, R6.1, U12.29 (MSEL2)
unnamed: C10.1, R69.2, U12.28 (VDD5)
unnamed: C13.1, R39.2, U12.33 (VOSNS)
unnamed: R4.2, R10.1, U12.30 (VSEL)

Notes on the sheet:
600 mA max
Power Monitor
PGD is an open drain output from the TPS546D24. Pull up to 3.3V
3V3 LDO
5V Supply
Max 1.0A
Output 1.2V nominal 40A max
I2C ADDR = 0x24
Power Monitoring
Connect at U3 Pin 37
I2C Address: 0x40
Troubleshooting I2C
5V LDO
Input 4-15V Input possible for TPS!!!

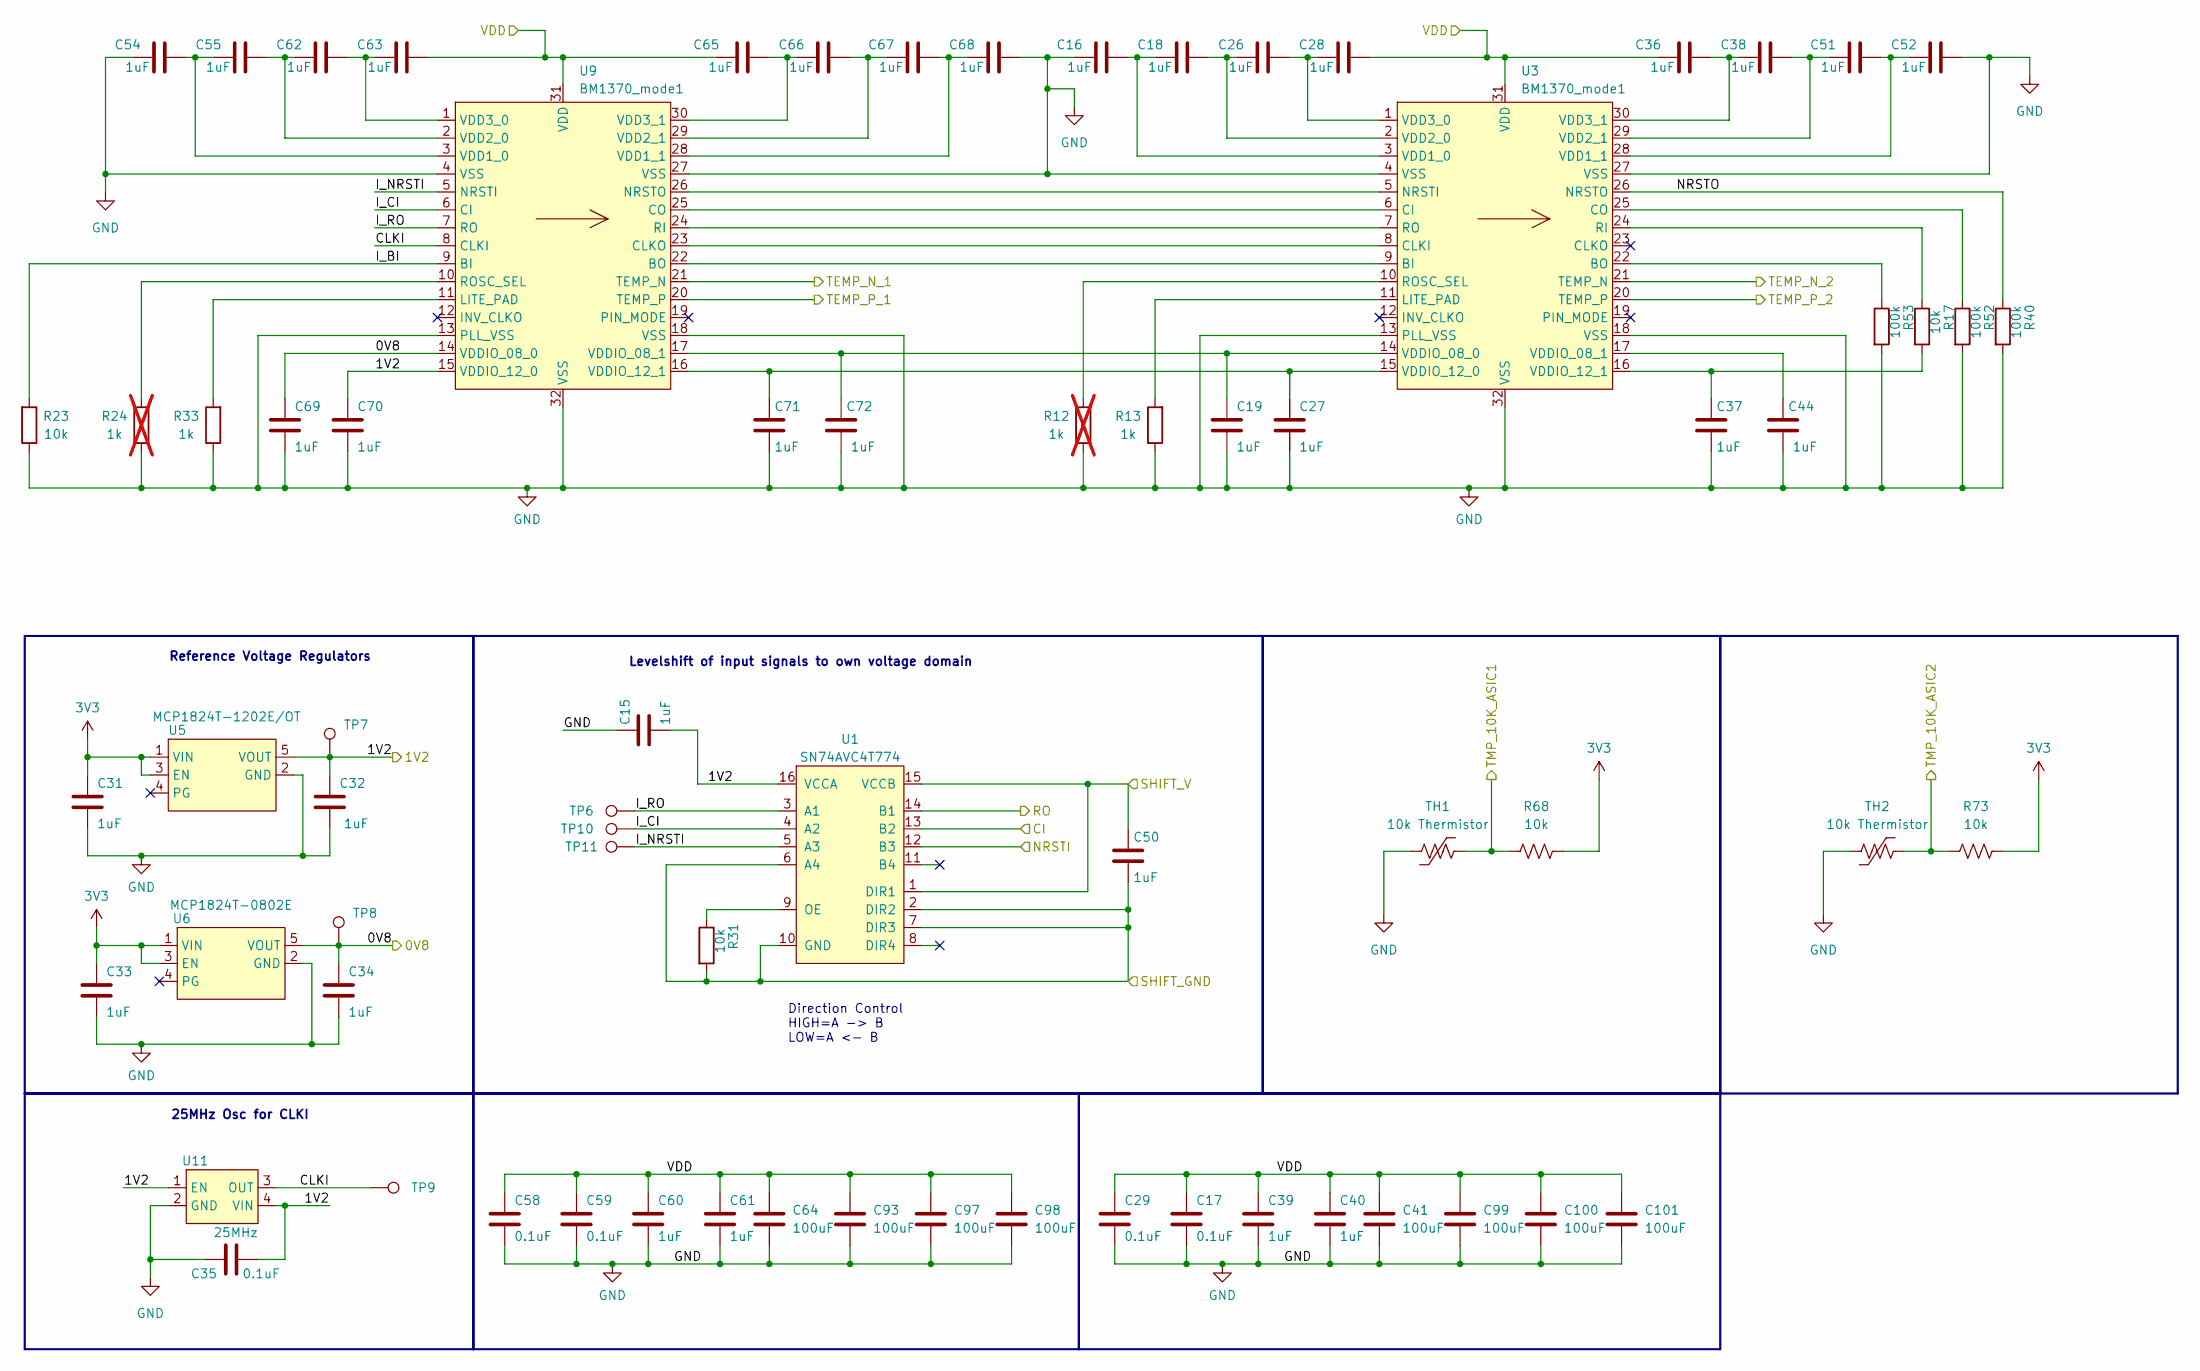
[picture p48: schematic Domain.kicad_sch, BitForgeNano]

Parts:
C15, C16, C18, C19, C26, C27, C28, C31, C32, C33, C34, C36, C37, C38, C39, C40, C44, C50, C51, C52, C54, C55, C60, C61, C62, C63, C65, C66, C67, C68, C69, C70, C71, C72: 1uF; C_0402_1005Metric; PARTNO EMK105BJ105MV-F
C17, C29, C35, C58, C59: 0.1uF; C_0805_2012Metric; PARTNO 0402X104K100CT
C41, C64: 100uF; C_1210_3225Metric
C93, C97, C98, C99, C100, C101: 100uF; C_1206_3216Metric
R12, R24: 1k; R_0201_0603Metric; PARTNO RC0402FR-071KL; not fitted
R13, R33: 1k; R_0402_1005Metric; PARTNO RC0402FR-071KL
R17, R31: 10k; R_0402_1005Metric
R23, R68, R73: 10k; R_0402_1005Metric; PARTNO RC0402JR-0710KL
R40, R52, R53: 100k; R_0402_1005Metric
TH1, TH2: 10k Thermistor; R_0402_1005Metric; PARTNO NTCG103JF103FT1
TP6, TP7, TP8, TP9, TP10, TP11: TestPoint; TestPoint_Pad_D1.0mm
U1: SN74AVC4T774; TSSOP-16_4.4x5mm_P0.65mm; PARTNO SN74AVC4T774PWR
U3, U9: BM1370_mode1; BM1370
U5: MCP1824T-1202E/OT; SOT-23-5; PARTNO MCP1824T-1202E/OT
U6: MCP1824T-0802E; SOT-23-5; PARTNO MCP1824T-0802E/OT
U11: 25MHz; O 25,0-JO32-B-1V3-1-T1-LF; PARTNO SX3M25.000E20F30THN; LCSC C5137262

Connections:
3V3: C31.1, C33.1, C50.1, R68.2, R73.2, U1.1 (DIR1), U1.15 (VCCB), U5.1 (VIN), U5.3 (EN), U6.1 (VIN), U6.3 (EN); also elsewhere on the board
/Domain/0V8: C34.1, C69.1, TP8.1, U6.5 (VOUT), U9.14 (VDDIO_08_0); also elsewhere on the board
/Domain/1V2: C15.2, C32.1, C35.2, C70.1, TP7.1, U1.16 (VCCA), U5.5 (VOUT), U9.15 (VDDIO_12_0), U11.1 (EN), U11.4 (VIN); also elsewhere on the board
/Domain/CLKI: TP9.1, U9.8 (CLKI), U11.3 (OUT)
/Domain/I_BI: R23.2, U9.9 (BI)
/Domain/I_CI: TP10.1, U1.4 (A2), U9.6 (CI)
/Domain/I_NRSTI: TP11.1, U1.5 (A3), U9.5 (NRSTI)
/Domain/I_RO: TP6.1, U1.3 (A1), U9.7 (RO)
/Domain/NRSTO: R40.1, U3.26 (NRSTO)
/RST: U1.12 (B3); also elsewhere on the board
/RX: U1.14 (B1); also elsewhere on the board
/TEMP_N_1: U9.21 (TEMP_N); also elsewhere on the board
/TEMP_N_2: U3.21 (TEMP_N); also elsewhere on the board
/TEMP_P_1: U9.20 (TEMP_P); also elsewhere on the board
/TEMP_P_2: U3.20 (TEMP_P); also elsewhere on the board
/TMP_10K_A1: R68.1, TH1.2; also elsewhere on the board
/TMP_10K_A2: R73.1, TH2.2; also elsewhere on the board
/TX: U1.13 (B2); also elsewhere on the board
/VDD: C17.1, C28.2, C29.1, C36.1, C39.1, C40.1, C41.1, C58.1, C59.1, C60.1, C61.1, C63.2, C64.1, C65.1, C93.1, C97.1, C98.1, C99.1, C100.1, C101.1, U3.31 (VDD), U9.31 (VDD); also elsewhere on the board
GND: C15.1, C16.1, C17.2, C19.2, C27.2, C29.2, C31.2, C32.2, C33.2, C34.2, C35.1, C37.2, C39.2, C40.2, C41.2, C44.2, C50.2, C52.2, C54.1, C58.2, C59.2, C60.2, C61.2, C64.2, C68.2, C69.2, C70.2, C71.2, C72.2, C93.2, C97.2, C98.2, C99.2, C100.2, C101.2, R12.1, R13.1, R23.1, R24.1, R31.2, R33.1, R40.2, R52.2, R53.2, TH1.1, TH2.1, U1.2 (DIR2), U1.6 (A4), U1.7 (DIR3), U1.10 (GND), U3.4 (VSS), U3.13 (PLL_VSS), U3.18 (VSS), U3.27 (VSS), U3.32 (VSS), U5.2 (GND), U6.2 (GND), U9.4 (VSS), U9.13 (PLL_VSS), U9.18 (VSS), U9.27 (VSS), U9.32 (VSS), U11.2 (GND); also elsewhere on the board
unnamed: R31.1, U1.9 (OE)
unnamed: U3.9 (BI), U9.22 (BO)
unnamed: R53.1, U3.22 (BO)
unnamed: U3.6 (CI), U9.25 (CO)
unnamed: U3.8 (CLKI), U9.23 (CLKO)
unnamed: R52.1, U3.25 (CO)
unnamed: R13.2, U3.11 (LITE_PAD)
unnamed: U3.5 (NRSTI), U9.26 (NRSTO)
unnamed: R17.1, U3.24 (RI)
unnamed: U3.7 (RO), U9.24 (RI)
unnamed: R12.2, U3.10 (ROSC_SEL)
unnamed: C16.2, C18.1, U3.3 (VDD1_0)
unnamed: C51.2, C52.1, U3.28 (VDD1_1)
unnamed: C18.2, C26.1, U3.2 (VDD2_0)
unnamed: C38.2, C51.1, U3.29 (VDD2_1)
unnamed: C26.2, C28.1, U3.1 (VDD3_0)
unnamed: C36.2, C38.1, U3.30 (VDD3_1)
unnamed: C19.1, C72.1, U3.14 (VDDIO_08_0), U9.17 (VDDIO_08_1)
unnamed: C44.1, U3.17 (VDDIO_08_1)
unnamed: C27.1, C71.1, U3.15 (VDDIO_12_0), U9.16 (VDDIO_12_1)
unnamed: C37.1, R17.2, U3.16 (VDDIO_12_1)
unnamed: R33.2, U9.11 (LITE_PAD)
unnamed: R24.2, U9.10 (ROSC_SEL)
unnamed: C54.2, C55.1, U9.3 (VDD1_0)
unnamed: C67.2, C68.1, U9.28 (VDD1_1)
unnamed: C55.2, C62.1, U9.2 (VDD2_0)
unnamed: C66.2, C67.1, U9.29 (VDD2_1)
unnamed: C62.2, C63.1, U9.1 (VDD3_0)
unnamed: C65.2, C66.1, U9.30 (VDD3_1)

Notes on the sheet:
25MHz Osc for CLKI
Direction Control HIGH=A -> B LOW=A <- B
Levelshift of input signals to own voltage domain
Reference Voltage Regulators

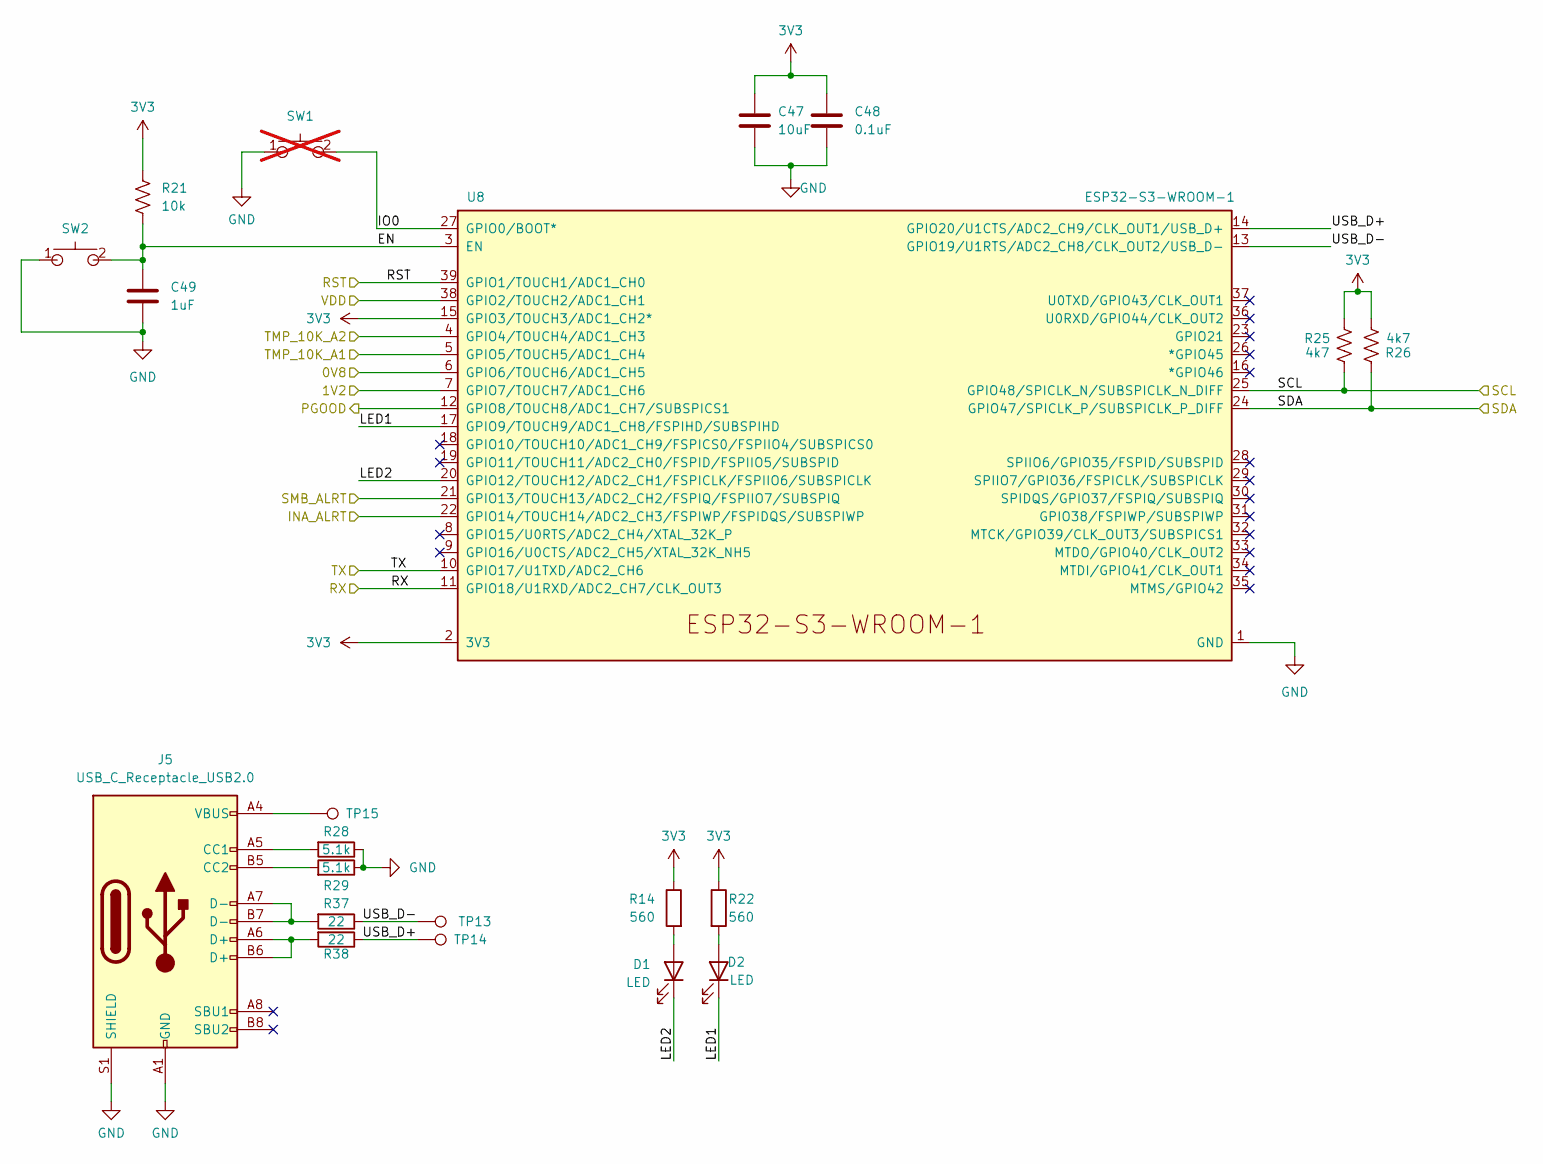
[picture p49: schematic ESP32.kicad_sch, BitForgeNano]

Parts:
C47: 10uF; C_0805_2012Metric; PARTNO CL21A106KOQNNNE
C48: 0.1uF; C_0805_2012Metric; PARTNO 0402X104K100CT
C49: 1uF; C_0805_2012Metric; PARTNO EMK105BJ105MV-F
D1, D2: LED; LED_0603_1608Metric
J5: USB_C_Receptacle_USB2.0; USB_C_Receptacle_GCT_USB4105-xx-A_16P_TopMnt_Horizontal
R14, R22: 560; R_0402_1005Metric
R21: 10k; R_0805_2012Metric; PARTNO RC0402JR-0710KL
R25, R26: 4k7; R_0402_1005Metric
R28, R29: 5.1k; R_0805_2012Metric
R37, R38: 22; R_0805_2012Metric
SW1: GT-TC029B-H025-L1N; SW_CS1213AGF260_CRS; PARTNO CS1213AGF260; not fitted
SW2: GT-TC029B-H025-L1N; SW_CS1213AGF260_CRS; PARTNO CS1213AGF260
TP13, TP14, TP15: TestPoint; TestPoint_Pad_D1.0mm
U8: ESP32-S3-WROOM-1; PARTNO ESP32-S3-WROOM-1-N16R8

Connections:
3V3: C47.1, C48.1, R14.1, R21.1, R22.1, R25.2, R26.1, U8.2 (3V3), U8.15 (GPIO3/TOUCH3/ADC1_CH2*); also elsewhere on the board
/Domain/0V8: U8.6 (GPIO6/TOUCH6/ADC1_CH5); also elsewhere on the board
/Domain/1V2: U8.7 (GPIO7/TOUCH7/ADC1_CH6); also elsewhere on the board
/ESP32/EN: C49.1, R21.2, SW2.2, U8.3 (EN)
/ESP32/INA_ALRT: U8.22 (GPIO14/TOUCH14/ADC2_CH3/FSPIWP/FSPIDQS/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); also elsewhere on the board
/ESP32/IO0: SW1.2, U8.27 (GPIO0/BOOT*)
/ESP32/LED1: D2.1 (K), U8.17 (GPIO9/TOUCH9/ADC1_CH8/FSPIHD/SUBSPIHD)
/ESP32/LED2: D1.1 (K), U8.20 (GPIO12/TOUCH12/ADC2_CH1/FSPICLK/FSPIIO6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)
/ESP32/USB_D+: R38.1, TP14.1, U8.14 (GPIO20/U1CTS/ADC2_CH9/CLK_OUT1/USB_D+)
/ESP32/USB_D-: R37.1, TP13.1, U8.13 (GPIO19/U1RTS/ADC2_CH8/CLK_OUT2/USB_D-)
/Power/PGOOD: U8.12 (GPIO8/TOUCH8/ADC1_CH7/SUBSPICS1); also elsewhere on the board
/Power/SMB_ALRT: U8.21 (GPIO13/TOUCH13/ADC2_CH2/FSPIQ/FSPIIO7/S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); also elsewhere on the board
/RST: U8.39 (GPIO1/TOUCH1/ADC1_CH0); also elsewhere on the board
/RX: U8.11 (GPIO18/U1RXD/ADC2_CH7/CLK_OUT3); also elsewhere on the board
/SCL: R25.1, U8.25 (GPIO48/SPICLK_N/SUBSPICLK_N_DIFF); also elsewhere on the board
/SDA: R26.2, U8.24 (GPIO47/SPICLK_P/SUBSPICLK_P_DIFF); also elsewhere on the board
/TMP_10K_A1: U8.5 (GPIO5/TOUCH5/ADC1_CH4); also elsewhere on the board
/TMP_10K_A2: U8.4 (GPIO4/TOUCH4/ADC1_CH3); also elsewhere on the board
/TX: U8.10 (GPIO17/U1TXD/ADC2_CH6); also elsewhere on the board
/VDD: U8.38 (GPIO2/TOUCH2/ADC1_CH1); also elsewhere on the board
GND: C47.2, C48.2, C49.2, J5.A1 (GND), J5.A12 (GND), J5.B1 (GND), J5.B12 (GND), J5.S1 (SHIELD), R28.1, R29.1, SW1.1, SW2.1, U8.1 (GND), U8.40 (GND), U8.41 (GND); also elsewhere on the board
unnamed: D1.2 (A), R14.2
unnamed: D2.2 (A), R22.2
unnamed: J5.A5 (CC1), R28.2
unnamed: J5.B5 (CC2), R29.2
unnamed: J5.A6 (D+), J5.B6 (D+), R38.2
unnamed: J5.A7 (D-), J5.B7 (D-), R37.2
unnamed: J5.A4 (VBUS), J5.A9 (VBUS), J5.B4 (VBUS), J5.B9 (VBUS), TP15.1

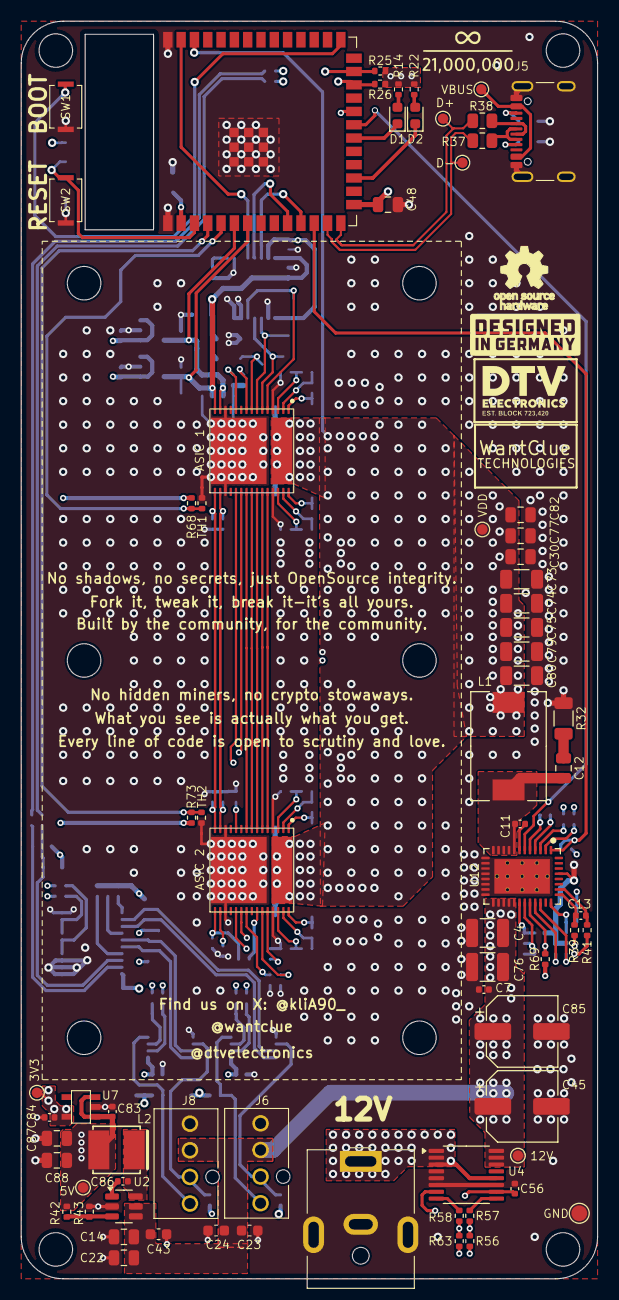
[picture p50: board BitForgeNano.kicad_pcb from above]

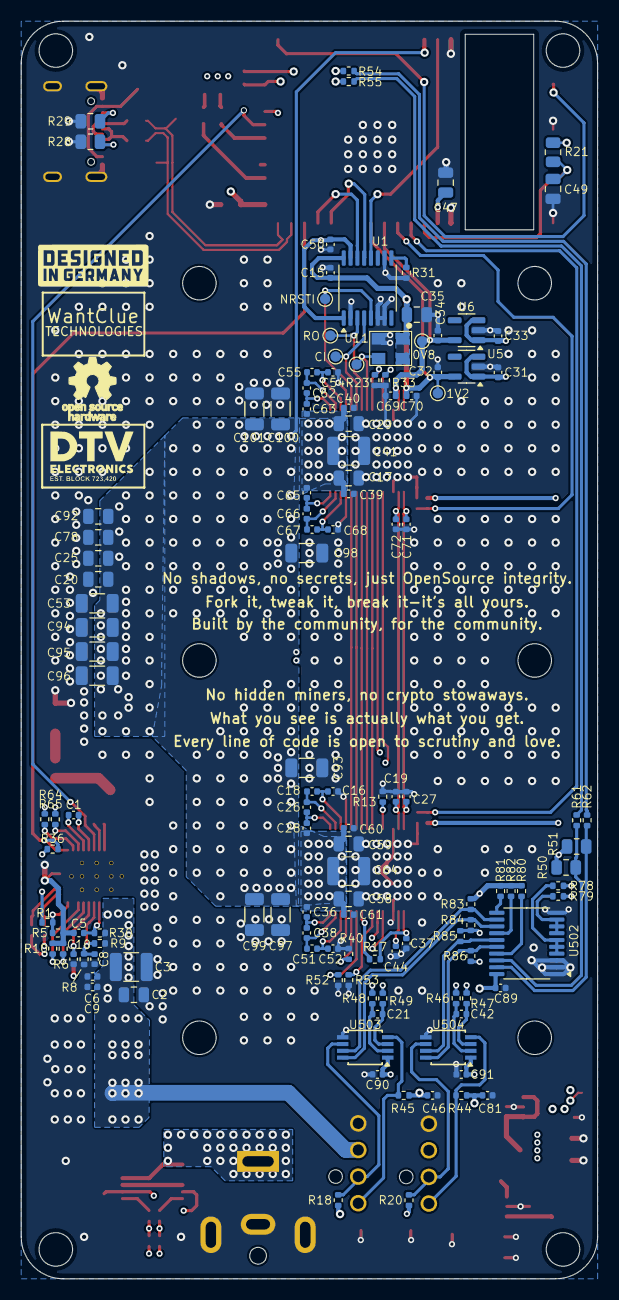
[picture p51: board BitForgeNano.kicad_pcb from below]

Board: 6 copper layers, 55.0 x 120.0 mm, 211 parts (130 on the bottom side), 110 nets.

Other parts of the board:
LOGO1#2: OPEN_HARDWARE; OSHW-Logo_5.7x6mm_SilkScreen
