parkourlrc/pcb-WantClueTechnologies--BitForge-Nano-ec7b885981/(notices)

Notices in the files:
KiCad/BitForgeNano/3d/ST-4ETB2k_(202).stp:
author */ ('License CC BY-ND 4.0'),
KiCad/BitForgeNano/Power.kicad_sch:
Licensed under CERN-OHL-W version 2
